Roboteurs/Pi-104/README.md

# Pi-104
Necessary files to build a PCIE/104 compliant carrier board for Raspberry Pi Compute module
