Roboteurs/Pi-104/hardware/bom.xlsx

 |  |  |  |  |  |  | Board Qty: | 100
 |  |  |  |  |  |  | Total Cost: | $0.00 |  |  |  | $0.00 |  |  |  |  |  | $0.00 |  |  |  |  |  | $0.00 |  |  |  |  |  | $0.00 |  |  |  |  |  | $0.00
 |  |  |  |  |  |  | Unit Cost: | $0.00
Global Part Info |  |  |  |  |  |  |  |  | Digi-Key |  |  |  |  |  | Farnell |  |  |  |  |  | Mouser |  |  |  |  |  | Newark |  |  |  |  |  | Rs Components
Refs | Value | Desc | Footprint | Manf | Manf# | Qty | Unit$ | Ext$ | Avail | Purch | Unit$ | Ext$ | Cat# | Doc | Avail | Purch | Unit$ | Ext$ | Cat# | Doc | Avail | Purch | Unit$ | Ext$ | Cat# | Doc | Avail | Purch | Unit$ | Ext$ | Cat# | Doc | Avail | Purch | Unit$ | Ext$ | Cat# | Doc
R8,R11,R12 | DNP |  | w_smd_resistors:r_0402 |  | - | 0 | $0.00 | $0.00
R9 | 30k |  | w_smd_resistors:r_0402 |  | ERJ-2RKF3002X | 0 | $0.00 | $0.00 | 144942 |  | $0.00 | $0.00 | P30.0KLCT-ND | Link (http://www.digikey.com/product-detail/en/panasonic-electronic-components/ERJ-2RKF3002X/P30.0KLCT-ND/1746668) | 60000 |  | $0.00 | $0.00 | 2397333 | Link (http://it.farnell.com/webapp/wcs/stores/servlet/Search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) | 78944 |  | $0.00 | $0.00 | 667-ERJ-2RKF3002X | Link (http://www.mouser.com/Search/Refine.aspx?Keyword=667-ERJ-2RKF3002X%20) | 3540 |  | $0.00 | $0.00 | 53W4321 | Link (http://www.newark.com/panasonic-electronic-components/erj-2rkf3002x/res-thick-film-30k-1-0-1w-0402/dp/53W4321) | 1 |  | $0.00 | $0.00 | 732-5438 | Link (http://it.rs-online.com/web/c/?searchTerm=ERJ-2RKF3002X%20)
J4 | RJ45_LEDS |  | project_foot:RJE72-188 |  | RJE721881411 | 0 | $0.00 | $0.00 | 73 |  | $0.00 | $0.00 | RJE72-188-1411-ND | Link (http://www.digikey.com/scripts/DkSearch/dksus.dll?WT.z_header=search_go&lang=en) | 118 |  | $0.00 | $0.00 | 2354249 | Link (http://it.farnell.com/amphenol-commercial-products/rje72-188-1411/jack-modulare-1-porta-8p8c-y-g/dp/2354249) | 404 |  | $0.00 | $0.00 | 523-RJE721881411 | Link (http://www.mouser.com/Search/Refine.aspx?Keyword=523-RJE721881411%20) | 529 |  | $0.00 | $0.00 | 47W2089 | Link (http://www.newark.com/webapp/wcs/stores/servlet/Search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)
R5 | 240 |  | w_smd_resistors:r_0603 |  | ESR03EZPJ241 | 0 | $0.00 | $0.00 | 43759 |  | $0.00 | $0.00 | RHM240DCT-ND | Link (http://www.digikey.com/product-detail/en/rohm-semiconductor/ESR03EZPJ241/RHM240DCT-ND/1762931) |  |  |  |  |  |  | 24616 |  | $0.00 | $0.00 | 755-ESR03EZPJ241 | Link (http://www.mouser.com/Search/Refine.aspx?Keyword=755-ESR03EZPJ241%20)
R4 | 24k |  | w_smd_resistors:r_0402 |  | ERJ-2GEJ243X | 0 | $0.00 | $0.00 | 21017 |  | $0.00 | $0.00 | P24KJCT-ND | Link (http://www.digikey.com/product-detail/en/panasonic-electronic-components/ERJ-2GEJ243X/P24KJCT-ND/146947) | 113735 |  | $0.00 | $0.00 | 2324288 | Link (http://it.farnell.com/panasonic-electronic-components/erj2gej243x/res-film-spesso-24k-5-0-1w-0402/dp/2324288) | 130424 |  | $0.00 | $0.00 | 667-ERJ-2GEJ243X | Link (http://www.mouser.com/Search/Refine.aspx?Keyword=667-ERJ-2GEJ243X%20) | 2534 |  | $0.00 | $0.00 | 53W4156 | Link (http://www.newark.com/panasonic-electronic-components/erj-2gej243x/res-thick-film-24k-5-0-1w-0402/dp/53W4156)
U2 | dmmt5401 |  | w_smd_trans:sot23-6 |  | DMMT5401-7-F | 0 | $0.00 | $0.00 | 26347 |  | $0.00 | $0.00 | DMMT5401-FDICT-ND | Link (http://www.digikey.com/product-detail/en/diodes-incorporated/DMMT5401-7-F/DMMT5401-FDICT-ND/717881) | 4157 |  | $0.00 | $0.00 | 1773583 | Link (http://it.farnell.com/diodes-inc/dmmt5401-7-f/transistor-accoppiato-pnp-pnp/dp/1773583) | 3089 |  | $0.00 | $0.00 | 621-DMMT5401-7-F | Link (http://www.mouser.com/Search/Refine.aspx?Keyword=621-DMMT5401-7-F%20) | 3629 |  | $0.00 | $0.00 | 51R6458 | Link (http://www.newark.com/webapp/wcs/stores/servlet/Search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) | 280 |  | $0.00 | $0.00 | 711-5049 | Link (http://it.rs-online.com/web/p/transistor-bipolari/7115049/)
F1 | 2A |  | w_smd_resistors:r_1206 |  | MF-NSMF200-2 | 0 | $0.00 | $0.00 | 12193 |  | $0.00 | $0.00 | MF-NSMF200-2CT-ND | Link (http://www.digikey.com/product-detail/en/bourns-inc/MF-NSMF200-2/MF-NSMF200-2CT-ND/1232791) |  |  |  |  |  |  | 8710 |  | $0.00 | $0.00 | 652-MF-NSMF200-2 | Link (http://www.mouser.com/Search/Refine.aspx?Keyword=652-MF-NSMF200-2%20) | 2957 |  | $0.00 | $0.00 | 75K7626 | Link (http://www.newark.com/bourns/nsmf200-2/fuse-ptc-reset-6v-2a-1206/dp/75K7626) |  |  |  |  |  | Link (http://it.rs-online.com/web/c/?searchTerm=MF-NSMF200-2%20)
R27-R30 | 49.9R |  | w_smd_resistors:r_0402 |  | RG1005P-49R9-B-T5 | 0 | $0.00 | $0.00 | 77420 |  | $0.00 | $0.00 | RG10P49.9BCT-ND | Link (http://www.digikey.com/product-detail/en/susumu/RG1005P-49R9-B-T5/RG10P49.9BCT-ND/969051) | 2476 |  | $0.00 | $0.00 | 2330716 | Link (http://it.farnell.com/te-connectivity/cpf0402b49r9e1/res-film-sott-49r9-0-1-0-063w/dp/2330716?iscrfnonsku=true) | 6849 |  | $0.00 | $0.00 | 754-RG1005P-49R9-BT5 | Link (http://www.mouser.com/Search/Refine.aspx?Keyword=754-RG1005P-49R9-BT5%20)
P11 | CAM0 FCI Connector |  | project_foot:1-84952-5 |  | 1-84952-5 | 0 | $0.00 | $0.00 | 9056 |  | $0.00 | $0.00 | A101391CT-ND | Link (http://www.digikey.com/product-detail/en/te-connectivity-amp-connectors/1-84952-5/A101391CT-ND/2567527) |  |  |  |  |  | Link (http://it.farnell.com/te-connectivity-amp/1-84952-5/fpc-connector-receptacle-15pos/dp/1846445) | 283 |  | $0.00 | $0.00 | 571-1-84952-5 | Link (http://www.mouser.com/Search/Refine.aspx?Keyword=571-1-84952-5%20%20) |  |  |  |  |  | Link (http://www.newark.com/webapp/wcs/stores/servlet/Search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)
SW3 | Switch_SPDT_x2 |  | project_foot:SSSS820201 |  | SSSS820201 | 0 | $0.00 | $0.00 |  |  |  |  |  |  |  |  |  |  |  |  | 385 |  | $0.00 | $0.00 | 688-SSSS820201 | Link (http://www.mouser.com/Search/Refine.aspx?Keyword=688-SSSS820201%20) |  |  |  |  |  |  |  |  |  |  |  | Link (http://it.rs-online.com/web/c/?searchTerm=SSSS820201%20)
U3 | PAM2306A |  | w_smd_qfn:dfn12 |  | PAM2306AYPKE | 0 | $0.00 | $0.00 |  |  |  |  |  | Link (http://www.digikey.com/scripts/DkSearch/dksus.dll?WT.z_header=search_go&lang=en) |  |  |  |  |  |  | 6730 |  | $0.00 | $0.00 | 621-PAM2306AYPKE | Link (http://www.mouser.com/Search/Refine.aspx?Keyword=621-PAM2306AYPKE%20) |  |  |  |  |  |  | 2140 |  | $0.00 | $0.00 | 921-0751 | Link (http://it.rs-online.com/web/c/?searchTerm=PAM2306AYPKE%20)
R1 | 10k |  | w_smd_resistors:r_0402 |  | ERJ-2GEJ103X | 0 | $0.00 | $0.00 | 4213026 |  | $0.00 | $0.00 | P10KJCT-ND | Link (http://www.digikey.com/product-detail/en/panasonic-electronic-components/ERJ-2GEJ103X/P10KJCT-ND/146734) | 55245 |  | $0.00 | $0.00 | 2059239 | Link (http://it.farnell.com/panasonic-electronic-components/erj2gej103x/res-film-spesso-10k-5-0-1w-0402/dp/2059239) | 1561201 |  | $0.00 | $0.00 | 667-ERJ-2GEJ103X | Link (http://www.mouser.com/Search/Refine.aspx?Keyword=667-ERJ-2GEJ103X%20) | 3111 |  | $0.00 | $0.00 | 65T8248 | Link (http://www.newark.com/panasonic-electronic-components/erj-2gej103x/res-thick-film-10k-5-0-1w-0402/dp/65T8248) |  |  |  |  |  | Link (http://it.rs-online.com/web/p/resistori-smd/7324861/)
C25,C26,C51,C52 | 100n/50V |  | w_smd_cap:c_0402 |  | GRM155R71H104KE14J | 0 | $0.00 | $0.00 | 4873 |  | $0.00 | $0.00 | 490-13342-1-ND | Link (http://www.digikey.com/product-detail/en/murata-electronics-north-america/GRM155R71H104KE14J/490-13342-1-ND/5973352) |  |  |  |  |  | Link (http://it.farnell.com/tdk/cga2b3x7r1h104k050bb/condensatore-mlcc-x7r-100nf-50v/dp/2210822?iscrfnonsku=true) | 270973 |  | $0.00 | $0.00 | 81-GRM155R71H104KE4J | Link (http://www.mouser.com/Search/../ProductDetail/Murata-Electronics/GRM155R71H104KE14J/) | 2390 |  | $0.00 | $0.00 | 04X3230 | Link (http://www.newark.com/tdk/c1005x7r1h104k050bb/ceramic-capacitor-0-1uf-50v-x7r/dp/04X3230?iscrfnonsku=true) |  |  |  |  |  | Link (http://it.rs-online.com/web/p/condensatori-ceramici-multistrato/8847087/)
D4 | LED |  | w_smd_leds:Led_0603 |  | HT-191YG-5310 | 0 | $0.00 | $0.00 |  |  |  |  |  |  |  |  |  |  |  |  | 579 |  | $0.00 | $0.00 | 743-HT-191YG | Link (http://www.mouser.com/Search/Refine.aspx?Keyword=743-HT-191YG%20)
X1 | 25.000MHz |  | w_crystal:crystal_smd_5x3.2mm |  | ABM3-25.000MHZ-B2-T | 0 | $0.00 | $0.00 | 13229 |  | $0.00 | $0.00 | 535-9108-1-ND | Link (http://www.digikey.com/product-detail/en/abracon-llc/ABM3-25.000MHZ-B2-T/535-9108-1-ND/675625) | 3868 |  | $0.00 | $0.00 | 1703612 | Link (http://it.farnell.com/abracon/abm3-25-000mhz-b2-t/crystal/dp/1703612) | 5304 |  | $0.00 | $0.00 | 815-ABM3-25-B2-T | Link (http://www.mouser.com/Search/Refine.aspx?Keyword=815-ABM3-25-B2-T%20) | 343 |  | $0.00 | $0.00 | 13J1725 | Link (http://www.newark.com/abracon/abm3-25-000mhz-b2-t/crystal-25mhz-18pf-5-x-3-2mm/dp/13J1725)
C15-C19 | 10nf/50V |  | w_smd_cap:c_0402 |  | 04025C103KAT2A | 0 | $0.00 | $0.00 | 168732 |  | $0.00 | $0.00 | 478-7882-1-ND | Link (http://www.digikey.com/product-detail/en/avx-corporation/04025C103KAT2A/478-7882-1-ND/3881505) | 2779 |  | $0.00 | $0.00 | 2332514 | Link (http://it.farnell.com/avx/04025c103kat2a/condensatore-mlcc-x7r-10nf-50v/dp/2332514) | 58594 |  | $0.00 | $0.00 | 581-04025C103KAT2A | Link (http://www.mouser.com/Search/../ProductDetail/AVX/04025C103KAT2A/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) | 3897 |  | $0.00 | $0.00 | 94W2844 | Link (http://www.newark.com/avx/04025c103kat2a/capacitor-ceramic-0-01uf-50v-x7r/dp/94W2844)
C3,C27,C30 | 4.7uf6.3V |  | w_smd_cap:c_0402 |  | 04026D475KAT2A | 0 | $0.00 | $0.00 |  |  |  |  |  |  |  |  |  |  |  |  | 4730 |  | $0.00 | $0.00 | 581-04026D475KAT2A | Link (http://www.mouser.com/Search/Refine.aspx?Keyword=581-04026D475KAT2A%20) |  |  |  |  |  | Link (http://www.newark.com/webapp/wcs/stores/servlet/Search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)
U7 | TS3USB3031 |  | project_foot:PWQFN-N12 |  | TS3USB3031RMGR | 0 | $0.00 | $0.00 | 1539 |  | $0.00 | $0.00 | 296-41018-1-ND | Link (http://www.digikey.com/product-detail/en/texas-instruments/TS3USB3031RMGR/296-41018-1-ND/5178895) |  |  |  |  |  |  | 5899 |  | $0.00 | $0.00 | 595-TS3USB3031RMGR | Link (http://www.mouser.com/Search/Refine.aspx?Keyword=595-TS3USB3031RMGR%20)
F2,F3 | 1A |  | w_smd_resistors:r_1206 |  | MF-NSMF075-2 | 0 | $0.00 | $0.00 | 5313 |  | $0.00 | $0.00 | MF-NSMF075-2CT-ND | Link (http://www.digikey.com/product-detail/en/bourns-inc/MF-NSMF075-2/MF-NSMF075-2CT-ND/662835) | 2296 |  | $0.00 | $0.00 | 1206719 | Link (http://it.farnell.com/bourns/nsmf075-2/multifuse-smd-0-75a/dp/1206719) |  |  |  |  |  |  |  |  |  |  |  |  | 560 |  | $0.00 | $0.00 | 647-8285 | Link (http://it.rs-online.com/web/c/?searchTerm=MF-NSMF075-2%20)
R31 | 10R |  | w_smd_resistors:r_0402 |  | RK73H1ERTTP10R0F | 0 | $0.00 | $0.00 |  |  |  |  |  |  | 20000 |  | $0.00 | $0.00 | 2355505 | Link (http://it.farnell.com/webapp/wcs/stores/servlet/Search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) |  |  |  |  |  |  | 15101 |  | $0.00 | $0.00 | 51W2911 | Link (http://www.newark.com/panasonic-electronic-components/erj-u02f10r0x/res-thick-film-10r-1-0-1w-0402/dp/51W2911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)
R53,R54,R56 | 47k |  | w_smd_resistors:r_0402 |  | CRCW040247K0FKED | 0 | $0.00 | $0.00 | 330389 |  | $0.00 | $0.00 | 541-47.0KLCT-ND | Link (http://www.digikey.com/product-detail/en/vishay-dale/CRCW040247K0FKED/541-47.0KLCT-ND/1183313) | 24658 |  | $0.00 | $0.00 | 1469719 | Link (http://it.farnell.com/vishay/crcw040247k0fked/res-film-spesso-47k-1-0-063w-0402/dp/1469719) |  |  |  |  |  |  | 8595 |  | $0.00 | $0.00 | 52K7097 | Link (http://www.newark.com/vishay/crcw040247k0fked/res-thick-film-47k-1-0-063w-0402/dp/52K7097) | 200 |  | $0.00 | $0.00 | 678-9361 | Link (http://it.rs-online.com/web/p/resistori-smd/6789361/)
C11,C12 | DNP |  | w_smd_cap:c_0402 |  | - | 0 | $0.00 | $0.00
L4-L6 | 2A FTBEAD |  | w_smd_inductors:inductor_smd_0603 |  | BLM18PG121SN1D | 0 | $0.00 | $0.00 | 815714 |  | $0.00 | $0.00 | 490-1037-1-ND | Link (http://www.digikey.com/product-detail/en/murata-electronics-north-america/BLM18PG121SN1D/490-1037-1-ND/584485) | 20477 |  | $0.00 | $0.00 | 1515738 | Link (http://it.farnell.com/murata/blm18pg121sn1d/ferrite-perlina-0603-0-05ohm-2a/dp/1515738) |  |  |  |  |  |  | 28852 |  | $0.00 | $0.00 | 73M9109 | Link (http://www.newark.com/webapp/wcs/stores/servlet/Search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) | 1100 |  | $0.00 | $0.00 | 724-1380 | Link (http://it.rs-online.com/web/c/?searchTerm=BLM18PG121SN1D%20)
R10 | 10k |  | w_smd_resistors:r_0402 |  | ERJ-2GEJ103X | 0 | $0.00 | $0.00 | 4213026 |  | $0.00 | $0.00 | P10KJCT-ND | Link (http://www.digikey.com/product-detail/en/panasonic-electronic-components/ERJ-2GEJ103X/P10KJCT-ND/146734) | 55245 |  | $0.00 | $0.00 | 2059239 | Link (http://it.farnell.com/panasonic-electronic-components/erj2gej103x/res-film-spesso-10k-5-0-1w-0402/dp/2059239) |  |  |  |  |  |  | 3111 |  | $0.00 | $0.00 | 65T8248 | Link (http://www.newark.com/panasonic-electronic-components/erj-2gej103x/res-thick-film-10k-5-0-1w-0402/dp/65T8248) |  |  |  |  |  | Link (http://it.rs-online.com/web/p/resistori-smd/7324861/)
U1 | AP7115 |  | w_smd_trans:sot323-5 |  | AP7115-25SEG-7 | 0 | $0.00 | $0.00 | 6966 |  | $0.00 | $0.00 | AP7115-25SEGDICT-ND | Link (http://www.digikey.com/product-detail/en/diodes-incorporated/AP7115-25SEG-7/AP7115-25SEGDICT-ND/2044560) |  |  |  |  |  |  |  |  |  |  |  |  |  |  |  |  |  |  | 2050 |  | $0.00 | $0.00 | 828-7656 | Link (http://it.rs-online.com/web/p/regolatori-di-tensione-low-dropout/8287656/)
D1 | 0.6V |  | w_smd_diode:do214aa |  | MBRS140 | 0 | $0.00 | $0.00 | 11948 |  | $0.00 | $0.00 | MBRS140FSCT-ND | Link (http://www.digikey.com/product-detail/en/fairchild-on-semiconductor/MBRS140/MBRS140FSCT-ND/2094422) |  |  |  |  |  |  |  |  |  |  |  |  | 721 |  | $0.00 | $0.00 | 58K1806 | Link (http://www.newark.com/fairchild-semiconductor/mbrs140/schottky-rectifier-1a-40v-do-214aa/dp/58K1806) | 362 |  | $0.00 | $0.00 | 545-2074 | Link (http://it.rs-online.com/web/p/diodi-rettificatori-e-schottky/5452074/)
R40 | 27k |  | w_smd_resistors:r_0402 |  | ERJ-2GEJ273X | 0 | $0.00 | $0.00 | 523925 |  | $0.00 | $0.00 | P27KJCT-ND | Link (http://www.digikey.com/product-detail/en/panasonic-electronic-components/ERJ-2GEJ273X/P27KJCT-ND/146955) | 1567 |  | $0.00 | $0.00 | 2059244 | Link (http://it.farnell.com/panasonic-electronic-components/erj2gej273x/res-film-spesso-27k-5-0-1w-0402/dp/2059244) |  |  |  |  |  |  | 6290 |  | $0.00 | $0.00 | 65T8276 | Link (http://www.newark.com/panasonic-electronic-components/erj-2gej273x/res-thick-film-27k-5-0-1w-0402/dp/65T8276) |  |  |  |  |  | Link (http://it.rs-online.com/web/c/?searchTerm=ERJ-2GEJ273X%20)
U10 | ESD5384 |  | project_foot:WLCSP9 |  | ESD5384NCTBG | 0 | $0.00 | $0.00 |  |  |  |  |  | Link (http://www.digikey.com/product-detail/en/on-semiconductor/ESD5384NCTBG/ESD5384NCTBGOSCT-ND/5801808) |  |  |  |  |  |  |  |  |  |  |  |  |  |  |  |  |  |  | 4500 |  | $0.00 | $0.00 | 801-0213 | Link (http://it.rs-online.com/web/c/?searchTerm=ESD5384NCTBG%20)
J2 | OneBank |  | project_foot:ASP-129646-22 |  | ASP-129646-22 | 0 | $0.00 | $0.00
Q2,Q3 | DMG1012T |  | project_foot:SOT523 |  | DMG1012T-7 | 0 | $0.00 | $0.00 | 231192 |  | $0.00 | $0.00 | DMG1012T-7DICT-ND | Link (http://www.digikey.com/product-detail/en/diodes-incorporated/DMG1012T-7/DMG1012T-7DICT-ND/2181232) | 927 |  | $0.00 | $0.00 | 2543524 | Link (http://it.farnell.com/diodes-inc/dmg1012t-7/mosfet-ca-n-20v-sot-523/dp/2543524) |  |  |  |  |  |  | 767 |  | $0.00 | $0.00 | 82Y6555 | Link (http://www.newark.com/webapp/wcs/stores/servlet/Search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) | 4700 |  | $0.00 | $0.00 | 751-4064 | Link (http://it.rs-online.com/web/p/transistor-mosfet/7514064/)
U5 | FDC5614P |  | w_smd_trans:sot23-6 |  | FDC5614P | 0 | $0.00 | $0.00 | 618 |  | $0.00 | $0.00 | FDC5614PCT-ND | Link (http://www.digikey.com/product-detail/en/fairchild-on-semiconductor/FDC5614P/FDC5614PCT-ND/965578) | 9489 |  | $0.00 | $0.00 | 1471036 | Link (http://it.farnell.com/fairchild-semiconductor/fdc5614p/mosfet-p-smd-ssot-6/dp/1471036) |  |  |  |  |  |  | 645 |  | $0.00 | $0.00 | 34C0107 | Link (http://www.newark.com/fairchild-semiconductor/fdc5614p/p-channel-mosfet-60v-3a-super/dp/34C0107) | 30 |  | $0.00 | $0.00 | 671-0346 | Link (http://it.rs-online.com/web/p/transistor-mosfet/6710346/)
J3 | MICRO_USB |  | w_conn_pc:conn_usb_B_micro_smd-2 |  | 47346-0001 | 0 | $0.00 | $0.00 |  |  |  |  |  |  | 7922 |  | $0.00 | $0.00 | 1568026 | Link (http://it.farnell.com/molex/47346-0001/micro-usb-2-0-tipo-b-presa-smt/dp/1568026) |  |  |  |  |  |  | 962 |  | $0.00 | $0.00 | 47M0505 | Link (http://www.newark.com/molex/47346-0001/micro-usb-2-0-type-b-receptacle/dp/47M0505) | 35 |  | $0.00 | $0.00 | 702-5475 | Link (http://it.rs-online.com/web/c/?searchTerm=47346-0001%20)
R20 | 12k |  | w_smd_resistors:r_0402 |  | CPF0402B12KE1 | 0 | $0.00 | $0.00 | 5181 |  | $0.00 | $0.00 | A102603CT-ND | Link (http://www.digikey.com/product-detail/en/te-connectivity-passive-product/CPF0402B12KE1/A102603CT-ND/2729136) | 2317 |  | $0.00 | $0.00 | 1697335 | Link (http://it.farnell.com/te-connectivity-neohm/cpf0402b12ke1/res-film-sott-12k-0-1-0-063w-0402/dp/1697335) |  |  |  |  |  |  | 1502 |  | $0.00 | $0.00 | 80P3858 | Link (http://www.newark.com/webapp/wcs/stores/servlet/Search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) |  |  |  |  |  | Link (http://it.rs-online.com/web/c/?searchTerm=CPF0402B12KE1%20)
U6 | DDR2_SODIMM |  | Sockets:Socket_SODIMM_DDR1-2_TE_1612618_Debug |  | 1612618-4 | 0 | $0.00 | $0.00 | 400 |  | $0.00 | $0.00 | A114913-ND | Link (http://www.digikey.com/scripts/DkSearch/dksus.dll?WT.z_header=search_go&lang=en) | 785 |  | $0.00 | $0.00 | 2396418 | Link (http://it.farnell.com/webapp/wcs/stores/servlet/Search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) |  |  |  |  |  |  | 4753 |  | $0.00 | $0.00 | 58K3620 | Link (http://www.newark.com/webapp/wcs/stores/servlet/Search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) | 18 |  | $0.00 | $0.00 | 718-4723 | Link (http://it.rs-online.com/web/c/?searchTerm=1612618-4%20)
L3 | 22uH/2.2A/100mO |  | w_smd_inductors:inductor_smd_8x5mm |  | SRN8040-220M | 0 | $0.00 | $0.00 | 16066 |  | $0.00 | $0.00 | SRN8040-220MCT-ND | Link (http://www.digikey.com/product-detail/en/bourns-inc/SRN8040-220M/SRN8040-220MCT-ND/2756182) | 1240 |  | $0.00 | $0.00 | 2061671 | Link (http://it.farnell.com/bourns/srn8040-220m/inductor-power-22uh-semi-shielded/dp/2061671) |  |  |  |  |  |  | 699 |  | $0.00 | $0.00 | 64T2399 | Link (http://www.newark.com/bourns/srn8040-220m/inductor-shielded-22uh-2-2a-smd/dp/64T2399) | 30 |  | $0.00 | $0.00 | 743-5188 | Link (http://it.rs-online.com/web/c/?searchTerm=SRN8040-220M%20)
SW1 | Rotary or Slide Select Switch |  | project_foot:SSSS820201 |  | SSSS820201 | 0 | $0.00 | $0.00 |  |  |  |  |  |  |  |  |  |  |  |  |  |  |  |  |  |  |  |  |  |  |  |  |  |  |  |  |  | Link (http://it.rs-online.com/web/c/?searchTerm=SSSS820201%20)
R14 | DNP |  | w_smd_resistors:r_0603 |  | - | 0 | $0.00 | $0.00
R6,R7,R13,R36-R39,R46-R48 | 0R |  | w_smd_resistors:r_0402 |  | CRCW04020000Z0ED | 0 | $0.00 | $0.00 | 1521711 |  | $0.00 | $0.00 | 541-0.0JCT-ND | Link (http://www.digikey.com/product-detail/en/vishay-dale/CRCW04020000Z0ED/541-0.0JCT-ND/1182611) | 69337 |  | $0.00 | $0.00 | 1469661 | Link (http://it.farnell.com/vishay/crcw04020000z0ed/resistore0r-0-063w-ponticello/dp/1469661) |  |  |  |  |  |  | 6692 |  | $0.00 | $0.00 | 52K6543 | Link (http://www.newark.com/vishay/crcw04020000z0ed/res-thick-film-0r-0-063w-0402/dp/52K6543) | 5000 |  | $0.00 | $0.00 | 393-2326 | Link (http://it.rs-online.com/web/p/resistori-smd/3932326/)
C8 | 1nf/50V |  | w_smd_resistors:r_0402 |  | GRM1555C1H102JA01D | 0 | $0.00 | $0.00 | 4073265 |  | $0.00 | $0.00 | 490-3244-1-ND | Link (http://www.digikey.com/product-detail/en/murata-electronics-north-america/GRM1555C1H102JA01D/490-3244-1-ND/702785) | 75951 |  | $0.00 | $0.00 | 8819556 | Link (http://it.farnell.com/murata/grm1555c1h102ja01d/condens-mlcc-c0g-np0-1nf-50v-0402/dp/8819556) |  |  |  |  |  |  | 4681 |  | $0.00 | $0.00 | 38K1651 | Link (http://www.newark.com/murata/grm1555c1h102ja01d/ceramic-capacitor-1000pf-50v-c0g/dp/38K1651) | 100 |  | $0.00 | $0.00 | 624-2913 | Link (http://it.rs-online.com/web/c/?searchTerm=GRM1555C1H102JA01D%20)
SW2 | DIPS_03 |  | project_foot:ADF03S04 |  | ADF03S04 | 0 | $0.00 | $0.00 |  |  |  |  |  |  |  |  |  |  |  |  |  |  |  |  |  |  |  |  |  |  |  |  | 48 |  | $0.00 | $0.00 | 639-3061 | Link (http://it.rs-online.com/web/p/interruttori-dip-e-sip/6393061/)
J5 | HDMI_CONN |  | project_foot:10029449-111RLF |  | 10029449-111RLF | 0 | $0.00 | $0.00 | 16146 |  | $0.00 | $0.00 | 609-4614-1-ND | Link (http://www.digikey.com/product-detail/en/amphenol-fci/10029449-111RLF/609-4614-1-ND/2785376) |  |  |  |  |  | Link (http://it.farnell.com/webapp/wcs/stores/servlet/Search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) |  |  |  |  |  |  |  |  |  |  |  | Link (http://www.newark.com/webapp/wcs/stores/servlet/Search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)
C20-C22,C24 | 47uf/10V |  | w_smd_cap:c_1210 |  | C1210C476M8PACTU | 0 | $0.00 | $0.00 | 36297 |  | $0.00 | $0.00 | 399-5515-1-ND | Link (http://www.digikey.com/product-detail/en/kemet/C1210C476M8PACTU/399-5515-1-ND/1950693) | 1234 |  | $0.00 | $0.00 | 2112938 | Link (http://it.farnell.com/kemet/c1210c476m8pactu/condensatore-mlcc-x5r-47uf-10v/dp/2112938) |  |  |  |  |  |  | 1874 |  | $0.00 | $0.00 | 12N4446 | Link (http://www.newark.com/kemet/c1210c476m8pactu/ceramic-capacitor-47uf-10v-x5r/dp/12N4446) | 235 |  | $0.00 | $0.00 | 803-0065 | Link (http://it.rs-online.com/web/p/condensatori-ceramici-multistrato/8030065/)
R65 | 1M |  | w_smd_resistors:r_0402 |  | CRCW04021M00FKED | 0 | $0.00 | $0.00 | 223527 |  | $0.00 | $0.00 | 541-1.00MLCT-ND | Link (http://www.digikey.com/product-detail/en/vishay-dale/CRCW04021M00FKED/541-1.00MLCT-ND/1183465) | 66016 |  | $0.00 | $0.00 | 1469667 | Link (http://it.farnell.com/vishay/crcw04021m00fked/res-film-spesso-1m-1-0-063w-0402/dp/1469667) |  |  |  |  |  |  | 7212 |  | $0.00 | $0.00 | 52K6593 | Link (http://www.newark.com/vishay/crcw04021m00fked/res-thick-film-1m-1-0-063w-0402/dp/52K6593) | 7750 |  | $0.00 | $0.00 | 678-8923 | Link (http://it.rs-online.com/web/p/resistori-smd/6788923/)
C5 | 4.7uf/50V |  | w_smd_cap:c_elec_4x5.7 |  | EMVA500ADA4R7MD55G | 0 | $0.00 | $0.00 | 2991 |  | $0.00 | $0.00 | 565-2128-1-ND | Link (http://www.digikey.com/product-detail/en/united-chemi-con/EMVA500ADA4R7MD55G/565-2128-1-ND/757289) | 4 |  | $0.00 | $0.00 | 1698399 | Link (http://it.farnell.com/webapp/wcs/stores/servlet/Search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) |  |  |  |  |  |  | 4 |  | $0.00 | $0.00 | 09P9249 | Link (http://www.newark.com/united-chemi-con/emva500ada4r7md55g/aluminum-electrolytic-capacitor/dp/09P9249) | 175 |  | $0.00 | $0.00 | 756-8017 | Link (http://it.rs-online.com/web/c/?searchTerm=EMVA500ADA4R7MD55G%20)
R51,R52,R55 | 1k |  | w_smd_resistors:r_0402 |  | CRCW04021K00FKED | 0 | $0.00 | $0.00 | 415249 |  | $0.00 | $0.00 | 541-1.00KLCT-ND | Link (http://www.digikey.com/product-detail/en/vishay-dale/CRCW04021K00FKED/541-1.00KLCT-ND/1183123) | 40809 |  | $0.00 | $0.00 | 1469662 | Link (http://it.farnell.com/vishay/crcw04021k00fked/res-film-spesso-1k-1-0-063w-0402/dp/1469662) |  |  |  |  |  |  | 6517 |  | $0.00 | $0.00 | 52K6545 | Link (http://www.newark.com/vishay/crcw04021k00fked/res-thick-film-1k-1-0-063w-0402/dp/52K6545) | 100 |  | $0.00 | $0.00 | 678-8872 | Link (http://it.rs-online.com/web/p/resistori-smd/6788872/)
P9,P13 | USB_A |  | project_foot:4825-80002 |  | 48258-0002 | 0 | $0.00 | $0.00 | 16608 |  | $0.00 | $0.00 | WM7087CT-ND | Link (http://www.digikey.com/product-detail/en/molex-llc/0482580002/WM7087CT-ND/3045006) |  |  |  |  |  |  |  |  |  |  |  |  | 11187 |  | $0.00 | $0.00 | 48T6726 | Link (http://www.newark.com/webapp/wcs/stores/servlet/Search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)
P10 | DISP0 FCI Connector |  | project_foot:1-84952-5 |  | 1-84952-5 | 0 | $0.00 | $0.00 | 9056 |  | $0.00 | $0.00 | A101391CT-ND | Link (http://www.digikey.com/product-detail/en/te-connectivity-amp-connectors/1-84952-5/A101391CT-ND/2567527) |  |  |  |  |  | Link (http://it.farnell.com/te-connectivity-amp/1-84952-5/fpc-connector-receptacle-15pos/dp/1846445) |  |  |  |  |  |  |  |  |  |  |  | Link (http://www.newark.com/webapp/wcs/stores/servlet/Search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)
R3,R41-R45 | 100k |  | w_smd_resistors:r_0402 |  | ERJ-2GEJ104X | 0 | $0.00 | $0.00 | 2402792 |  | $0.00 | $0.00 | P100KJCT-ND | Link (http://www.digikey.com/product-detail/en/panasonic-electronic-components/ERJ-2GEJ104X/P100KJCT-ND/146730) | 20693 |  | $0.00 | $0.00 | 2059250 | Link (http://it.farnell.com/panasonic-electronic-components/erj2gej104x/res-film-spesso-100k-5-0-1w-0402/dp/2059250) |  |  |  |  |  |  | 1106 |  | $0.00 | $0.00 | 65T8249 | Link (http://www.newark.com/panasonic-electronic-components/erj-2gej104x/res-thick-film-100k-5-0-1w-0402/dp/65T8249) |  |  |  |  |  | Link (http://it.rs-online.com/web/c/?searchTerm=ERJ-2GEJ104X%20)
R17,R32,R33,R35,R49 | 390R |  | w_smd_resistors:r_0402 |  | ERJ-2RKF3900X | 0 | $0.00 | $0.00 | 118516 |  | $0.00 | $0.00 | P390LCT-ND | Link (http://www.digikey.com/product-detail/en/panasonic-electronic-components/ERJ-2RKF3900X/P390LCT-ND/1746681) | 9951 |  | $0.00 | $0.00 | 2302590 | Link (http://it.farnell.com/panasonic-electronic-components/erj2rkf3900x/res-film-spesso-390r-1-0-1w-0402/dp/2302590) |  |  |  |  |  |  | 11745 |  | $0.00 | $0.00 | 64R5282 | Link (http://www.newark.com/panasonic-electronic-components/erj-2rkf3900x/res-thick-film-390r-1-0-1w-0402/dp/64R5282) |  |  |  |  |  | Link (http://it.rs-online.com/web/c/?searchTerm=ERJ-2RKF3900X%20)
T1 | H1102 |  | project_foot:H1102 |  | H1102NL | 0 | $0.00 | $0.00 | 7235 |  | $0.00 | $0.00 | 553-1323-5-ND | Link (http://www.digikey.com/product-detail/en/pulse-electronics-corporation/H1102NL/553-1323-5-ND/1036940)
P12 | CONN_02X20 |  | w_conn_strip:vasch_strip_20x2 |  | N2540-6002RB | 0 | $0.00 | $0.00 | 1738 |  | $0.00 | $0.00 | MHC40K-ND | Link (http://www.digikey.com/scripts/DkSearch/dksus.dll?WT.z_header=search_go&lang=en) | 584 |  | $0.00 | $0.00 | 9838309 | Link (http://it.farnell.com/3m/n2540-6002rb/header-diritta-40-vie/dp/9838309) |  |  |  |  |  |  | 96 |  | $0.00 | $0.00 | 18M6812 | Link (http://www.newark.com/webapp/wcs/stores/servlet/Search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) |  |  |  |  |  | Link (http://it.rs-online.com/web/c/?searchTerm=N2540-6002RB%20)
C32,C35 | 27pf |  | w_smd_cap:c_0402 |  | 04025A270FAT2A | 0 | $0.00 | $0.00 |  |  |  |  |  | Link (http://www.digikey.com/scripts/DkSearch/dksus.dll?WT.z_header=search_go&lang=en) | 5916 |  | $0.00 | $0.00 | 2332503 | Link (http://it.farnell.com/avx/04025a270fat2a/condens-mlcc-c0g-np0-27pf-50v/dp/2332503) |  |  |  |  |  |  | 15076 |  | $0.00 | $0.00 | 94W2841 | Link (http://www.newark.com/avx/04025a270fat2a/capacitor-ceramic-27pf-50v-c0g/dp/94W2841) |  |  |  |  |  | Link (http://it.rs-online.com/web/c/?searchTerm=04025A270FAT2A%20)
C4 | 100nf/50V |  | w_smd_cap:c_0402 |  | GRM155R71H104KE14J | 0 | $0.00 | $0.00 | 4873 |  | $0.00 | $0.00 | 490-13342-1-ND | Link (http://www.digikey.com/product-detail/en/murata-electronics-north-america/GRM155R71H104KE14J/490-13342-1-ND/5973352) |  |  |  |  |  | Link (http://it.farnell.com/tdk/cga2b3x7r1h104k050bb/condensatore-mlcc-x7r-100nf-50v/dp/2210822?iscrfnonsku=true) |  |  |  |  |  |  | 2390 |  | $0.00 | $0.00 | 04X3230 | Link (http://www.newark.com/tdk/c1005x7r1h104k050bb/ceramic-capacitor-0-1uf-50v-x7r/dp/04X3230?iscrfnonsku=true) |  |  |  |  |  | Link (http://it.rs-online.com/web/p/condensatori-ceramici-multistrato/8847087/)
C1 | 1uf/6V |  | w_smd_resistors:r_0402 |  | GRM155R70J105KA12J | 0 | $0.00 | $0.00 | 7495 |  | $0.00 | $0.00 | 490-10024-1-ND | Link (http://www.digikey.com/product-detail/en/murata-electronics-north-america/GRM155R70J105KA12D/490-10024-1-ND/5026378) |  |  |  |  |  |  |  |  |  |  |  |  |  |  |  |  |  |  | 2500 |  | $0.00 | $0.00 | 113-8711 | Link (http://it.rs-online.com/web/p/condensatori-ceramici-multistrato/1138711/)
C23,C28,C29,C31,C33,C34,C36-C44 | 0.1uf/50V |  | w_smd_cap:c_0402 |  | GRM155R71H104KE14J | 0 | $0.00 | $0.00 | 4873 |  | $0.00 | $0.00 | 490-13342-1-ND | Link (http://www.digikey.com/product-detail/en/murata-electronics-north-america/GRM155R71H104KE14J/490-13342-1-ND/5973352) |  |  |  |  |  | Link (http://it.farnell.com/tdk/cga2b3x7r1h104k050bb/condensatore-mlcc-x7r-100nf-50v/dp/2210822?iscrfnonsku=true) |  |  |  |  |  |  | 2390 |  | $0.00 | $0.00 | 04X3230 | Link (http://www.newark.com/tdk/c1005x7r1h104k050bb/ceramic-capacitor-0-1uf-50v-x7r/dp/04X3230?iscrfnonsku=true) |  |  |  |  |  | Link (http://it.rs-online.com/web/p/condensatori-ceramici-multistrato/8847087/)
U12-U17 | Hole |  |  |  |  | 0 | $0.00 | $0.00
R15,R16 | 47R |  | w_smd_resistors:r_0402 |  | RG1005P-470-D-T10 | 0 | $0.00 | $0.00 | 38820 |  | $0.00 | $0.00 | 408-1675-1-ND | Link (http://www.digikey.com/product-detail/en/susumu/RG1005P-470-D-T10/408-1675-1-ND/1288068) | 8827 |  | $0.00 | $0.00 | 2324743 | Link (http://it.farnell.com/webapp/wcs/stores/servlet/Search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)
R2 | 47k |  | w_smd_resistors:r_0402 |  | CRCW040247K0FKED | 0 | $0.00 | $0.00 | 330389 |  | $0.00 | $0.00 | 541-47.0KLCT-ND | Link (http://www.digikey.com/product-detail/en/vishay-dale/CRCW040247K0FKED/541-47.0KLCT-ND/1183313) | 24658 |  | $0.00 | $0.00 | 1469719 | Link (http://it.farnell.com/vishay/crcw040247k0fked/res-film-spesso-47k-1-0-063w-0402/dp/1469719) |  |  |  |  |  |  | 8595 |  | $0.00 | $0.00 | 52K7097 | Link (http://www.newark.com/vishay/crcw040247k0fked/res-thick-film-47k-1-0-063w-0402/dp/52K7097) | 200 |  | $0.00 | $0.00 | 678-9361 | Link (http://it.rs-online.com/web/p/resistori-smd/6789361/)
R61-R64 | 1.8k |  | w_smd_resistors:r_0402 |  | ERJ-2GEJ182X | 0 | $0.00 | $0.00 | 160836 |  | $0.00 | $0.00 | P1.8KJCT-ND | Link (http://www.digikey.com/product-detail/en/panasonic-electronic-components/ERJ-2GEJ182X/P1.8KJCT-ND/146921) | 18066 |  | $0.00 | $0.00 | 2324274 | Link (http://it.farnell.com/panasonic-electronic-components/erj2gej182x/res-film-spesso-1k8-5-0-1w-0402/dp/2324274) |  |  |  |  |  |  | 610 |  | $0.00 | $0.00 | 53W4149 | Link (http://www.newark.com/panasonic-electronic-components/erj-2gej182x/res-thick-film-1k8-5-0-1w-0402/dp/53W4149)
C2 | 100nf/50V |  | w_smd_resistors:r_0402 |  | GRM155R71H104KE14J | 0 | $0.00 | $0.00 | 4873 |  | $0.00 | $0.00 | 490-13342-1-ND | Link (http://www.digikey.com/product-detail/en/murata-electronics-north-america/GRM155R71H104KE14J/490-13342-1-ND/5973352) |  |  |  |  |  | Link (http://it.farnell.com/tdk/cga2b3x7r1h104k050bb/condensatore-mlcc-x7r-100nf-50v/dp/2210822?iscrfnonsku=true) |  |  |  |  |  |  | 2390 |  | $0.00 | $0.00 | 04X3230 | Link (http://www.newark.com/tdk/c1005x7r1h104k050bb/ceramic-capacitor-0-1uf-50v-x7r/dp/04X3230?iscrfnonsku=true) |  |  |  |  |  | Link (http://it.rs-online.com/web/p/condensatori-ceramici-multistrato/8847087/)
P8 | Raspberry_Pi_+_Conn |  | w_conn_strip:vasch_strip_20x2 |  | N2540-6002RB | 0 | $0.00 | $0.00 | 1738 |  | $0.00 | $0.00 | MHC40K-ND | Link (http://www.digikey.com/scripts/DkSearch/dksus.dll?WT.z_header=search_go&lang=en) | 584 |  | $0.00 | $0.00 | 9838309 | Link (http://it.farnell.com/3m/n2540-6002rb/header-diritta-40-vie/dp/9838309) |  |  |  |  |  |  | 96 |  | $0.00 | $0.00 | 18M6812 | Link (http://www.newark.com/webapp/wcs/stores/servlet/Search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) |  |  |  |  |  | Link (http://it.rs-online.com/web/c/?searchTerm=N2540-6002RB%20)
C45 | 0.022uf/50V |  | w_smd_cap:c_0402 |  | 0402YC223KAT4A | 0 | $0.00 | $0.00 |  |  |  |  |  |  | 1125 |  | $0.00 | $0.00 | 2070384 | Link (http://it.farnell.com/kemet/c0402c223k4racauto/condensatore-mlcc-x7r-22nf-16v/dp/2070384?iscrfnonsku=true) |  |  |  |  |  |  |  |  |  |  |  | Link (http://www.newark.com/webapp/wcs/stores/servlet/Search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) |  |  |  |  |  | Link (http://it.rs-online.com/web/p/condensatori-ceramici-multistrato/6983188/)
U8 | LAN9514I-JZX |  | project_foot:QFN50P900X900X100-65N |  | LAN9514I-JZX | 0 | $0.00 | $0.00 | 1073 |  | $0.00 | $0.00 | LAN9514I-JZX-ND | Link (http://www.digikey.com/scripts/DkSearch/dksus.dll?WT.z_header=search_go&lang=en) | 2 |  | $0.00 | $0.00 | 2407829 | Link (http://it.farnell.com/webapp/wcs/stores/servlet/Search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) |  |  |  |  |  |  | 2 |  | $0.00 | $0.00 | 69W9526 | Link (http://www.newark.com/webapp/wcs/stores/servlet/Search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) | 9 |  | $0.00 | $0.00 | 798-5248 | Link (http://it.rs-online.com/web/p/controller-ethernet/7985248/)
U4 | LM3489 |  | w_smd_dil:msoic-8 |  | LM3489MM/NOPB | 0 | $0.00 | $0.00 | 9049 |  | $0.00 | $0.00 | LM3489MM/NOPBCT-ND | Link (http://www.digikey.com/product-detail/en/texas-instruments/LM3489MM-NOPB/LM3489MM-NOPBCT-ND/1095944) | 2000 |  | $0.00 | $0.00 | 2436034 | Link (http://it.farnell.com/texas-instruments/lm3489mm-nopb/controllore-buck-pfet-smd-msop8/dp/2436034) |  |  |  |  |  |  | 741 |  | $0.00 | $0.00 | 99K2420 | Link (http://www.newark.com/texas-instruments/lm3489mm-nopb/pfet-buck-controller-msop-8/dp/99K2420) | 15 |  | $0.00 | $0.00 | 655-0589 | Link (http://it.rs-online.com/web/c/?searchTerm=LM3489MM%2FNOPB%20)
D8,D9 | SMBJ5.0A |  | w_smd_diode:do214aa |  | SMBJ5.0A | 0 | $0.00 | $0.00 | 49382 |  | $0.00 | $0.00 | SMBJ5.0ALFCT-ND | Link (http://www.digikey.com/product-detail/en/littelfuse-inc/SMBJ5.0A/SMBJ5.0ALFCT-ND/285951) | 10613 |  | $0.00 | $0.00 | 2097845 | Link (http://it.farnell.com/bourns/smbj5-0a/diodo-tvs-5v-600w-smb/dp/2097845) |  |  |  |  |  |  |  |  |  |  |  |  |  |  |  |  |  | Link (http://it.rs-online.com/web/p/diodi-tvs/6287304/)
D2,D3 | BAS16D |  | w_smd_diode:sod123 |  | BAS16D-E3-08 | 0 | $0.00 | $0.00 |  |  |  |  |  | Link (http://www.digikey.com/scripts/DkSearch/dksus.dll?WT.z_header=search_go&lang=en) |  |  |  |  |  |  |  |  |  |  |  |  |  |  |  |  |  | Link (http://www.newark.com/webapp/wcs/stores/servlet/Search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) |  |  |  |  |  | Link (http://it.rs-online.com/web/c/?searchTerm=BAS16D-E3-08%20)
J1 | OneBank |  | project_foot:ASP-129637-13 |  | ASP-129637-13 | 0 | $0.00 | $0.00
C46,C47,C49,C50 | 15pf/50V |  | w_smd_cap:c_0402 |  | GRM1555C1H150JA01D | 0 | $0.00 | $0.00 | 1413352 |  | $0.00 | $0.00 | 490-5888-1-ND | Link (http://www.digikey.com/product-detail/en/murata-electronics-north-america/GRM1555C1H150JA01D/490-5888-1-ND/3315234) | 24240 |  | $0.00 | $0.00 | 2218840 | Link (http://it.farnell.com/murata/grm1555c1h150ja01d/condens-mlcc-c0g-np0-15pf-50v/dp/2218840) |  |  |  |  |  |  | 19780 |  | $0.00 | $0.00 | 48W5742 | Link (http://www.newark.com/webapp/wcs/stores/servlet/Search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) | 1000 |  | $0.00 | $0.00 | 790-2758 | Link (http://it.rs-online.com/web/c/?searchTerm=GRM1555C1H150JA01D%20)
Q4,Q5 | DMG1012T |  | project_foot:SOT523 |  | DMG1012T-7 | 0 | $0.00 | $0.00 | 231192 |  | $0.00 | $0.00 | DMG1012T-7DICT-ND | Link (http://www.digikey.com/product-detail/en/diodes-incorporated/DMG1012T-7/DMG1012T-7DICT-ND/2181232) | 927 |  | $0.00 | $0.00 | 2543524 | Link (http://it.farnell.com/diodes-inc/dmg1012t-7/mosfet-ca-n-20v-sot-523/dp/2543524) |  |  |  |  |  |  | 767 |  | $0.00 | $0.00 | 82Y6555 | Link (http://www.newark.com/webapp/wcs/stores/servlet/Search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) | 4700 |  | $0.00 | $0.00 | 751-4064 | Link (http://it.rs-online.com/web/p/transistor-mosfet/7514064/)
R57-R60 | 75R |  | w_smd_resistors:r_0402 |  | ERJ-2RKF75R0X | 0 | $0.00 | $0.00 | 457782 |  | $0.00 | $0.00 | P75.0LCT-ND | Link (http://www.digikey.com/product-detail/en/panasonic-electronic-components/ERJ-2RKF75R0X/P75.0LCT-ND/194513) | 25580 |  | $0.00 | $0.00 | 2059111 | Link (http://it.farnell.com/panasonic-electronic-components/erj2rkf75r0x/res-film-spesso-75r-1-0-1w-0402/dp/2059111) |  |  |  |  |  |  | 10803 |  | $0.00 | $0.00 | 73T6540 | Link (http://www.newark.com/panasonic-electronic-components/erj-2rkf75r0x/res-thick-film-75r-1-0-063w-0402/dp/73T6540) | 1 |  | $0.00 | $0.00 | 732-5606 | Link (http://it.rs-online.com/web/c/?searchTerm=ERJ-2RKF75R0X%20)
D6 | LED RED |  | w_smd_leds:Led_0603 |  | HT-191USD-5313 | 0 | $0.00 | $0.00
P2 | Industrial Power Screw Terminal |  | project_foot:796644-2 |  | 571-796644-2 | 0 | $0.00 | $0.00 | 1182 |  | $0.00 | $0.00 | A98248-ND | Link (http://www.digikey.com/scripts/DkSearch/dksus.dll?WT.z_header=search_go&lang=en) |  |  |  |  |  | Link (http://it.farnell.com/webapp/wcs/stores/servlet/Search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)
D5 | LED GREEN |  | w_smd_leds:Led_0603 |  | HT-191YG-5310 | 0 | $0.00 | $0.00
Q1 | DMG2305UX |  | w_smd_trans:sot23 |  | DMG2305UX-7 | 0 | $0.00 | $0.00 | 83137 |  | $0.00 | $0.00 | DMG2305UX-7DICT-ND | Link (http://www.digikey.com/product-detail/en/diodes-incorporated/DMG2305UX-7/DMG2305UX-7DICT-ND/4340665) | 1565 |  | $0.00 | $0.00 | 2543533 | Link (http://it.farnell.com/diodes-inc/dmg2305ux-7/mosfet-ca-p-20v-sot-23-3/dp/2543533) |  |  |  |  |  |  | 1565 |  | $0.00 | $0.00 | 82Y6564 | Link (http://www.newark.com/webapp/wcs/stores/servlet/Search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) | 1600 |  | $0.00 | $0.00 | 827-0452 | Link (http://it.rs-online.com/web/p/transistor-mosfet/8270452/)
L1,L2 | 4.7uH/2A/107mR |  | Inductors:Inductor_Taiyo-Yuden_MD-4040 |  | MDWK4040T4R7MM | 0 | $0.00 | $0.00 | 550 |  | $0.00 | $0.00 | 587-4451-1-ND | Link (http://www.digikey.com/product-detail/en/taiyo-yuden/MDWK4040T4R7MM/587-4451-1-ND/5880041) |  |  |  |  |  |  |  |  |  |  |  |  |  |  |  |  |  | Link (http://www.newark.com/webapp/wcs/stores/servlet/Search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)
C7,C10 | 0.1uf/50V |  | w_smd_resistors:r_0402 |  | GRM155R71H104KE14J | 0 | $0.00 | $0.00 | 4873 |  | $0.00 | $0.00 | 490-13342-1-ND | Link (http://www.digikey.com/product-detail/en/murata-electronics-north-america/GRM155R71H104KE14J/490-13342-1-ND/5973352) |  |  |  |  |  | Link (http://it.farnell.com/tdk/cga2b3x7r1h104k050bb/condensatore-mlcc-x7r-100nf-50v/dp/2210822?iscrfnonsku=true) |  |  |  |  |  |  | 2390 |  | $0.00 | $0.00 | 04X3230 | Link (http://www.newark.com/tdk/c1005x7r1h104k050bb/ceramic-capacitor-0-1uf-50v-x7r/dp/04X3230?iscrfnonsku=true) |  |  |  |  |  | Link (http://it.rs-online.com/web/p/condensatori-ceramici-multistrato/8847087/)
C53 | C |  | w_smd_cap:c_0402 |  | - | 0 | $0.00 | $0.00
R18,R19,R21-R24 | 10k |  | w_smd_resistors:r_0402 |  | ERJ-2GEJ103X | 0 | $0.00 | $0.00 | 4213026 |  | $0.00 | $0.00 | P10KJCT-ND | Link (http://www.digikey.com/product-detail/en/panasonic-electronic-components/ERJ-2GEJ103X/P10KJCT-ND/146734) | 55245 |  | $0.00 | $0.00 | 2059239 | Link (http://it.farnell.com/panasonic-electronic-components/erj2gej103x/res-film-spesso-10k-5-0-1w-0402/dp/2059239) |  |  |  |  |  |  | 3111 |  | $0.00 | $0.00 | 65T8248 | Link (http://www.newark.com/panasonic-electronic-components/erj-2gej103x/res-thick-film-10k-5-0-1w-0402/dp/65T8248) |  |  |  |  |  | Link (http://it.rs-online.com/web/p/resistori-smd/7324861/)
P1,P3-P7,P14 | TST |  | Measurement_Points:Measurement_Point_Round-SMD-Pad_Small |  | - | 0 | $0.00 | $0.00
U11 | AP2331W |  | w_smd_trans:sot23 |  | AP2331W-7 | 0 | $0.00 | $0.00 | 3630 |  | $0.00 | $0.00 | AP2331W-7DICT-ND | Link (http://www.digikey.com/product-detail/en/diodes-incorporated/AP2331W-7/AP2331W-7DICT-ND/4251580) |  |  |  |  |  |  |  |  |  |  |  |  |  |  |  |  |  |  | 1900 |  | $0.00 | $0.00 | 828-7665 | Link (http://it.rs-online.com/web/p/switch-di-potenza-intelligenti/8287665/)
C6,C9,C13,C14 | 10uf/10V |  | w_smd_cap:c_0805 |  | GRM21BR71A106KE51L | 0 | $0.00 | $0.00 | 2409021 |  | $0.00 | $0.00 | 490-3905-1-ND | Link (http://www.digikey.com/product-detail/en/murata-electronics-north-america/GRM21BR71A106KE51L/490-3905-1-ND/965947) | 42516 |  | $0.00 | $0.00 | 1828828 | Link (http://it.farnell.com/murata/grm21br71a106ke51l/condensatore-mlcc-x7r-10uf-10v/dp/1828828) |  |  |  |  |  |  | 290 |  | $0.00 | $0.00 | 14T3345 | Link (http://www.newark.com/murata/grm21br71a106ke51l/ceramic-capacitor-10uf-10v-x7r/dp/14T3345) | 100 |  | $0.00 | $0.00 | 723-6060 | Link (http://it.rs-online.com/web/c/?searchTerm=GRM21BR71A106KE51L%20)
 |  |  |  |  |  |  |  |  |  | 0 | 0 | 0 |  |  |  | 0 | 0 | 0 |  |  |  | 0 | 0 | 0 |  |  |  | 0 | 0 | 0 |  |  |  | 0 | 0 | 0
 |  |  |  |  |  |  |  |  |  | 0 | 0 | 0 |  |  |  | 0 | 0 | 0 |  |  |  | 0 | 0 | 0 |  |  |  | 0 | 0 | 0 |  |  |  | 0 | 0 | 0
 |  |  |  |  |  |  |  |  |  | 0 | 0 | 0 |  |  |  | 0 | 0 | 0 |  |  |  | 0 | 0 | 0 |  |  |  | 0 | 0 | 0 |  |  |  | 0 | 0 | 0
 |  |  |  |  |  |  |  |  |  | 0 | 0 | 0 |  |  |  | 0 | 0 | 0 |  |  |  | 0 | 0 | 0 |  |  |  | 0 | 0 | 0 |  |  |  | 0 | 0 | 0
 |  |  |  |  |  |  |  |  |  | 0 | 0 | 0 |  |  |  | 0 | 0 | 0 |  |  |  | 0 | 0 | 0 |  |  |  | 0 | 0 | 0 |  |  |  | 0 | 0 | 0
 |  |  |  |  |  |  |  |  |  | 0 | 0 | 0 |  |  |  | 0 | 0 | 0 |  |  |  | 0 | 0 | 0 |  |  |  | 0 | 0 | 0 |  |  |  | 0 | 0 | 0
 |  |  |  |  |  |  |  |  |  | 0 | 0 | 0 |  |  |  | 0 | 0 | 0 |  |  |  | 0 | 0 | 0 |  |  |  | 0 | 0 | 0 |  |  |  | 0 | 0 | 0
 |  |  |  |  |  |  |  |  |  | 0 | 0 | 0 |  |  |  | 0 | 0 | 0 |  |  |  | 0 | 0 | 0 |  |  |  | 0 | 0 | 0 |  |  |  | 0 | 0 | 0
 |  |  |  |  |  |  |  |  |  | 0 | 0 | 0 |  |  |  | 0 | 0 | 0 |  |  |  | 0 | 0 | 0 |  |  |  | 0 | 0 | 0 |  |  |  | 0 | 0 | 0
 |  |  |  |  |  |  |  |  |  | 0 | 0 | 0 |  |  |  | 0 | 0 | 0 |  |  |  | 0 | 0 | 0 |  |  |  | 0 | 0 | 0 |  |  |  | 0 | 0 | 0
 |  |  |  |  |  |  |  |  |  | 0 | 0 | 0 |  |  |  | 0 | 0 | 0 |  |  |  | 0 | 0 | 0 |  |  |  | 0 | 0 | 0 |  |  |  | 0 | 0 | 0
 |  |  |  |  |  |  |  |  |  | 0 | 0 | 0 |  |  |  | 0 | 0 | 0 |  |  |  | 0 | 0 | 0 |  |  |  | 0 | 0 | 0 |  |  |  | 0 | 0 | 0
 |  |  |  |  |  |  |  |  |  | 0 | 0 | 0 |  |  |  | 0 | 0 | 0 |  |  |  | 0 | 0 | 0 |  |  |  | 0 | 0 | 0 |  |  |  | 0 | 0 | 0
 |  |  |  |  |  |  |  |  |  | 0 | 0 | 0 |  |  |  | 0 | 0 | 0 |  |  |  | 0 | 0 | 0 |  |  |  | 0 | 0 | 0 |  |  |  | 0 | 0 | 0
 |  |  |  |  |  |  |  |  |  | 0 | 0 | 0 |  |  |  | 0 | 0 | 0 |  |  |  | 0 | 0 | 0 |  |  |  | 0 | 0 | 0 |  |  |  | 0 | 0 | 0
 |  |  |  |  |  |  |  |  |  | 0 | 0 | 0 |  |  |  | 0 | 0 | 0 |  |  |  | 0 | 0 | 0 |  |  |  | 0 | 0 | 0 |  |  |  | 0 | 0 | 0
 |  |  |  |  |  |  |  |  |  | 0 | 0 | 0 |  |  |  | 0 | 0 | 0 |  |  |  | 0 | 0 | 0 |  |  |  | 0 | 0 | 0 |  |  |  | 0 | 0 | 0
 |  |  |  |  |  |  |  |  |  | 0 | 0 | 0 |  |  |  | 0 | 0 | 0 |  |  |  | 0 | 0 | 0 |  |  |  | 0 | 0 | 0 |  |  |  | 0 | 0 | 0
 |  |  |  |  |  |  |  |  |  | 0 | 0 | 0 |  |  |  | 0 | 0 | 0 |  |  |  | 0 | 0 | 0 |  |  |  | 0 | 0 | 0 |  |  |  | 0 | 0 | 0
 |  |  |  |  |  |  |  |  |  | 0 | 0 | 0 |  |  |  | 0 | 0 | 0 |  |  |  | 0 | 0 | 0 |  |  |  | 0 | 0 | 0 |  |  |  | 0 | 0 | 0
 |  |  |  |  |  |  |  |  |  | 0 | 0 | 0 |  |  |  | 0 | 0 | 0 |  |  |  | 0 | 0 | 0 |  |  |  | 0 | 0 | 0 |  |  |  | 0 | 0 | 0
 |  |  |  |  |  |  |  |  |  | 0 | 0 | 0 |  |  |  | 0 | 0 | 0 |  |  |  | 0 | 0 | 0 |  |  |  | 0 | 0 | 0 |  |  |  | 0 | 0 | 0
 |  |  |  |  |  |  |  |  |  | 0 | 0 | 0 |  |  |  | 0 | 0 | 0 |  |  |  | 0 | 0 | 0 |  |  |  | 0 | 0 | 0 |  |  |  | 0 | 0 | 0
 |  |  |  |  |  |  |  |  |  | 0 | 0 | 0 |  |  |  | 0 | 0 | 0 |  |  |  | 0 | 0 | 0 |  |  |  | 0 | 0 | 0 |  |  |  | 0 | 0 | 0
 |  |  |  |  |  |  |  |  |  | 0 | 0 | 0 |  |  |  | 0 | 0 | 0 |  |  |  | 0 | 0 | 0 |  |  |  | 0 | 0 | 0 |  |  |  | 0 | 0 | 0
 |  |  |  |  |  |  |  |  |  | 0 | 0 | 0 |  |  |  | 0 | 0 | 0 |  |  |  | 0 | 0 | 0 |  |  |  | 0 | 0 | 0 |  |  |  | 0 | 0 | 0
 |  |  |  |  |  |  |  |  |  | 0 | 0 | 0 |  |  |  | 0 | 0 | 0 |  |  |  | 0 | 0 | 0 |  |  |  | 0 | 0 | 0 |  |  |  | 0 | 0 | 0
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
 |  |  |  |  |  |  |  |  |  | 0 | 0 | 0 |  |  |  | 0 | 0 | 0 |  |  |  | 0 | 0 | 0 |  |  |  | 0 | 0 | 0 |  |  |  | 0 | 0 | 0
 |  |  |  |  |  |  |  |  |  | 0 | 0 | 0 |  |  |  | 0 | 0 | 0 |  |  |  | 0 | 0 | 0 |  |  |  | 0 | 0 | 0 |  |  |  | 0 | 0 | 0
