Roboteurs/Pi-104/hardware/RPi PCIe104 OB Compute Mod.pdf

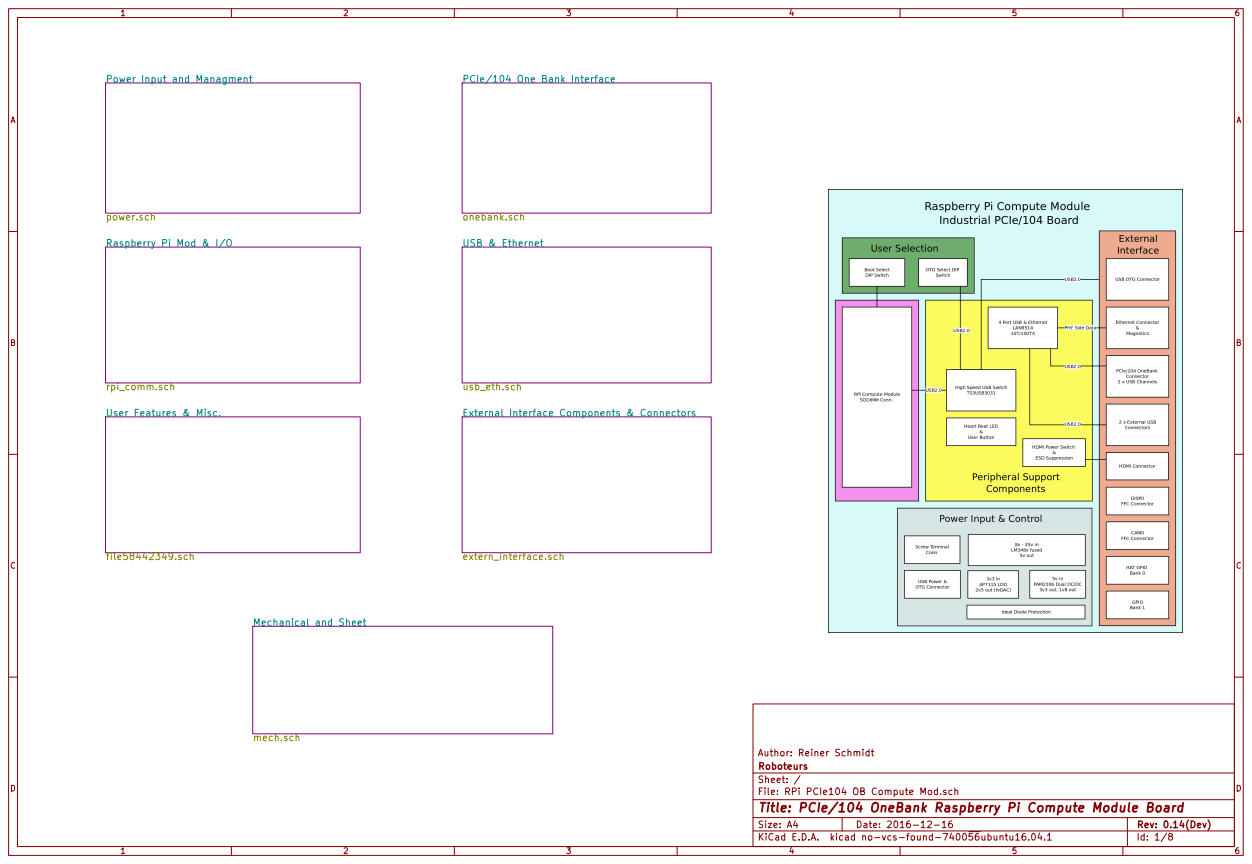
[picture p1: page 1]

Power Input and Managment

PCIe/104 One Bank Interface

onebank.sch USB & Ethernet

rpi_comm.sch User Features & Misc.

External Interface Components & Connectors

File: RPi PCIe104 OB Compute Mod.sch Sheet: / Roboteurs Author: Reiner Schmidt

Id: 1/8 Title: PCIe/104 OneBank Raspberry Pi Compute Module Board

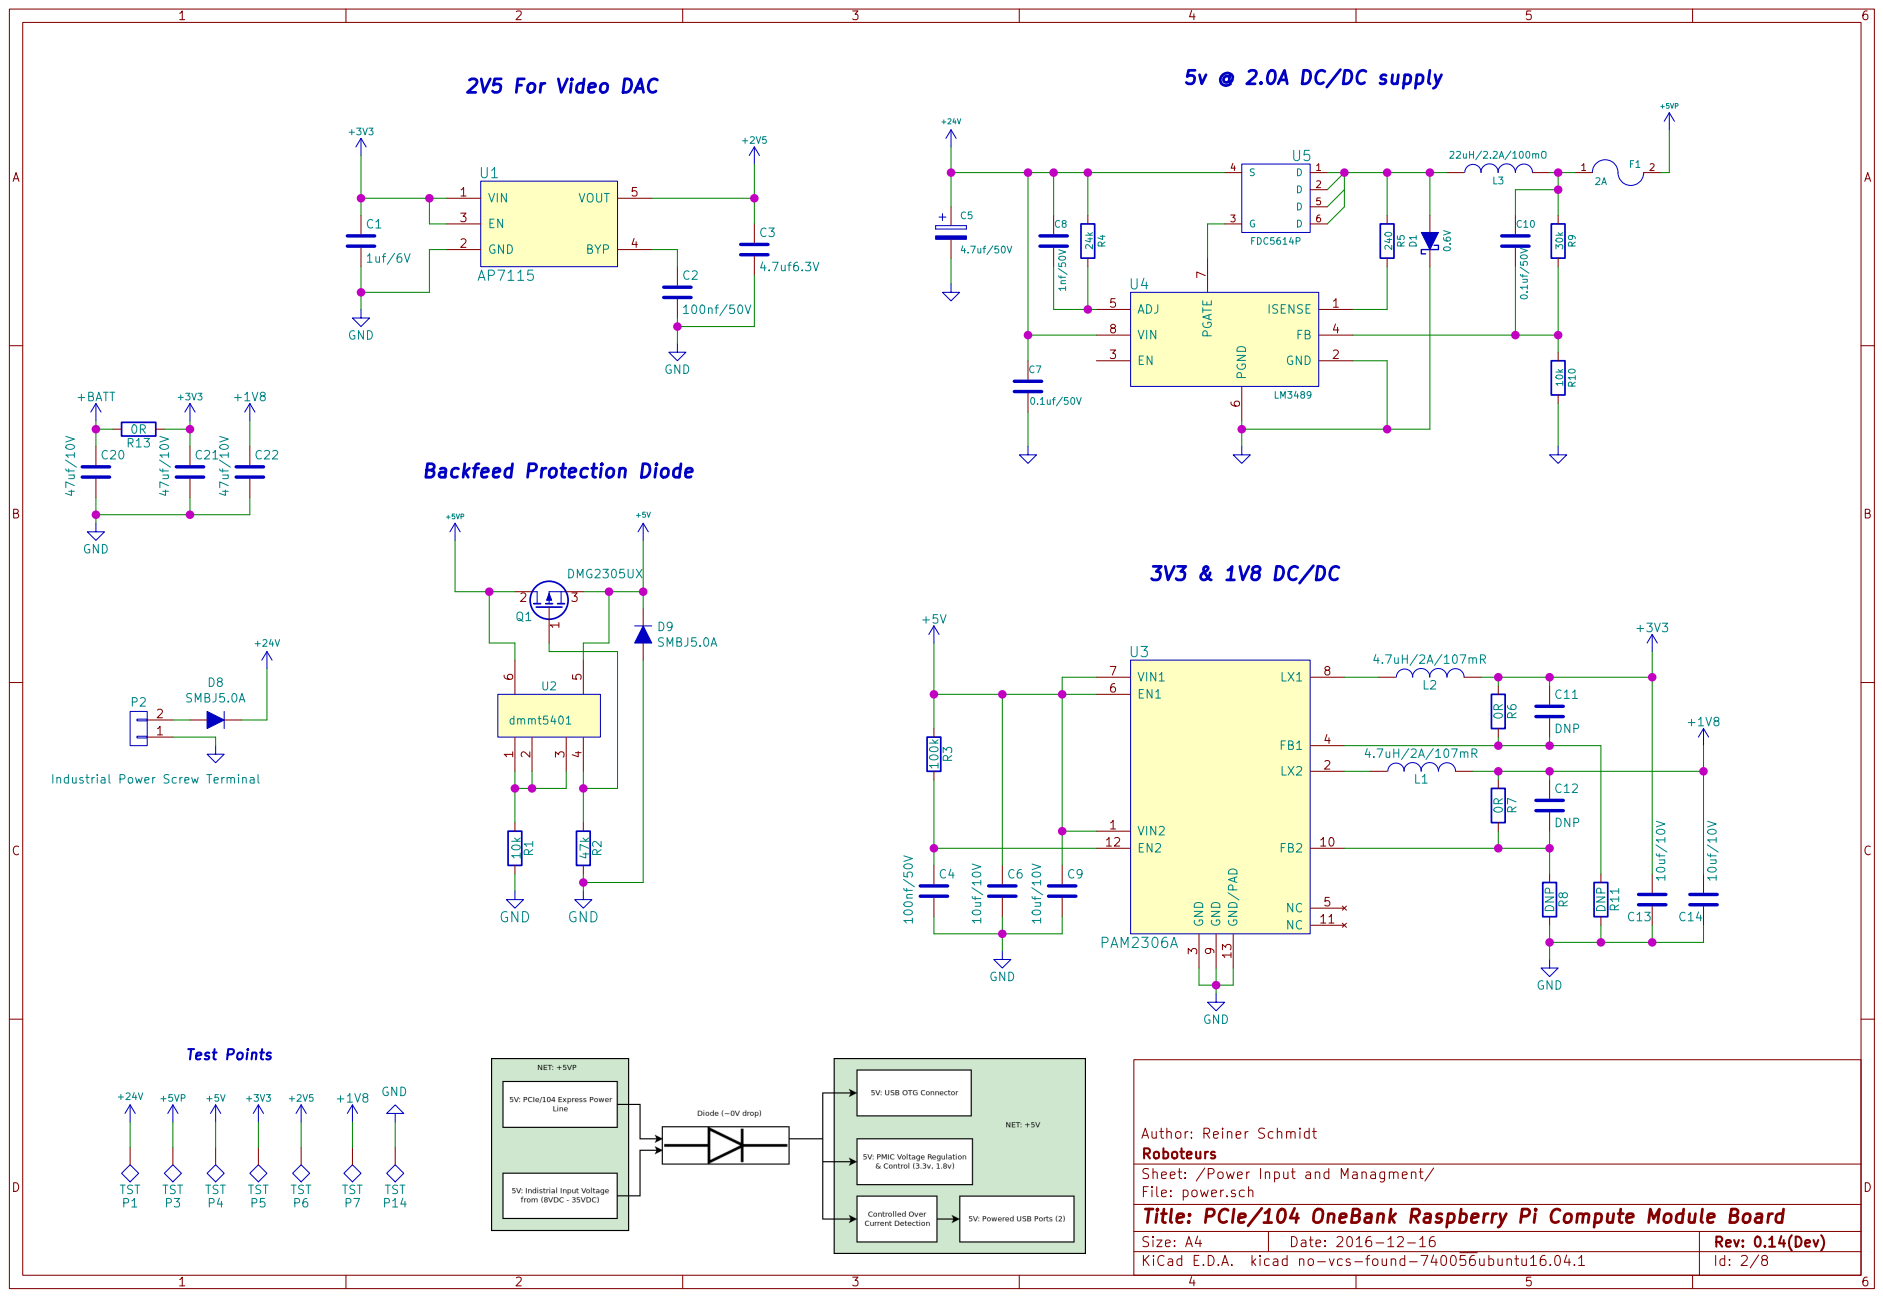
[picture p2: page 2]

Sheet: /Power Input and Managment/ Roboteurs Author: Reiner Schmidt

File: power.sch
Id: 2/8 Title: PCIe/104 OneBank Raspberry Pi Compute Module Board

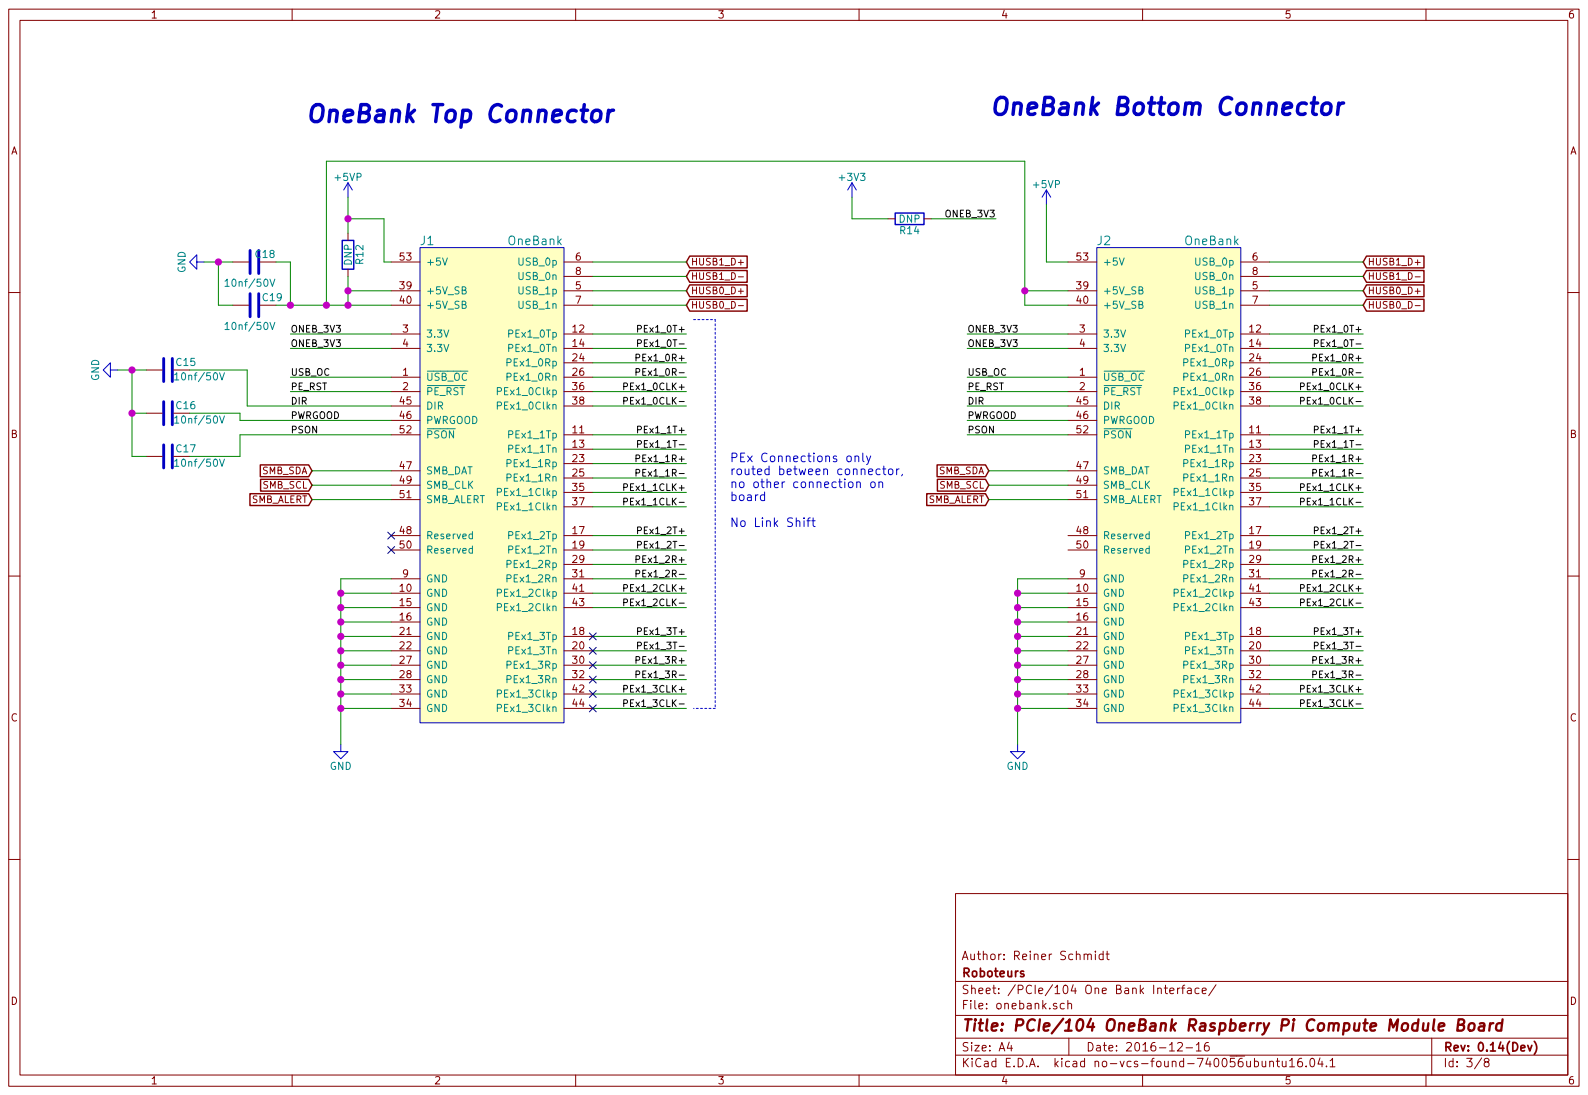
[picture p3: page 3]

File: onebank.sch Sheet: /PCIe/104 One Bank Interface/ Roboteurs Author: Reiner Schmidt

Id: 3/8 Title: PCIe/104 OneBank Raspberry Pi Compute Module Board

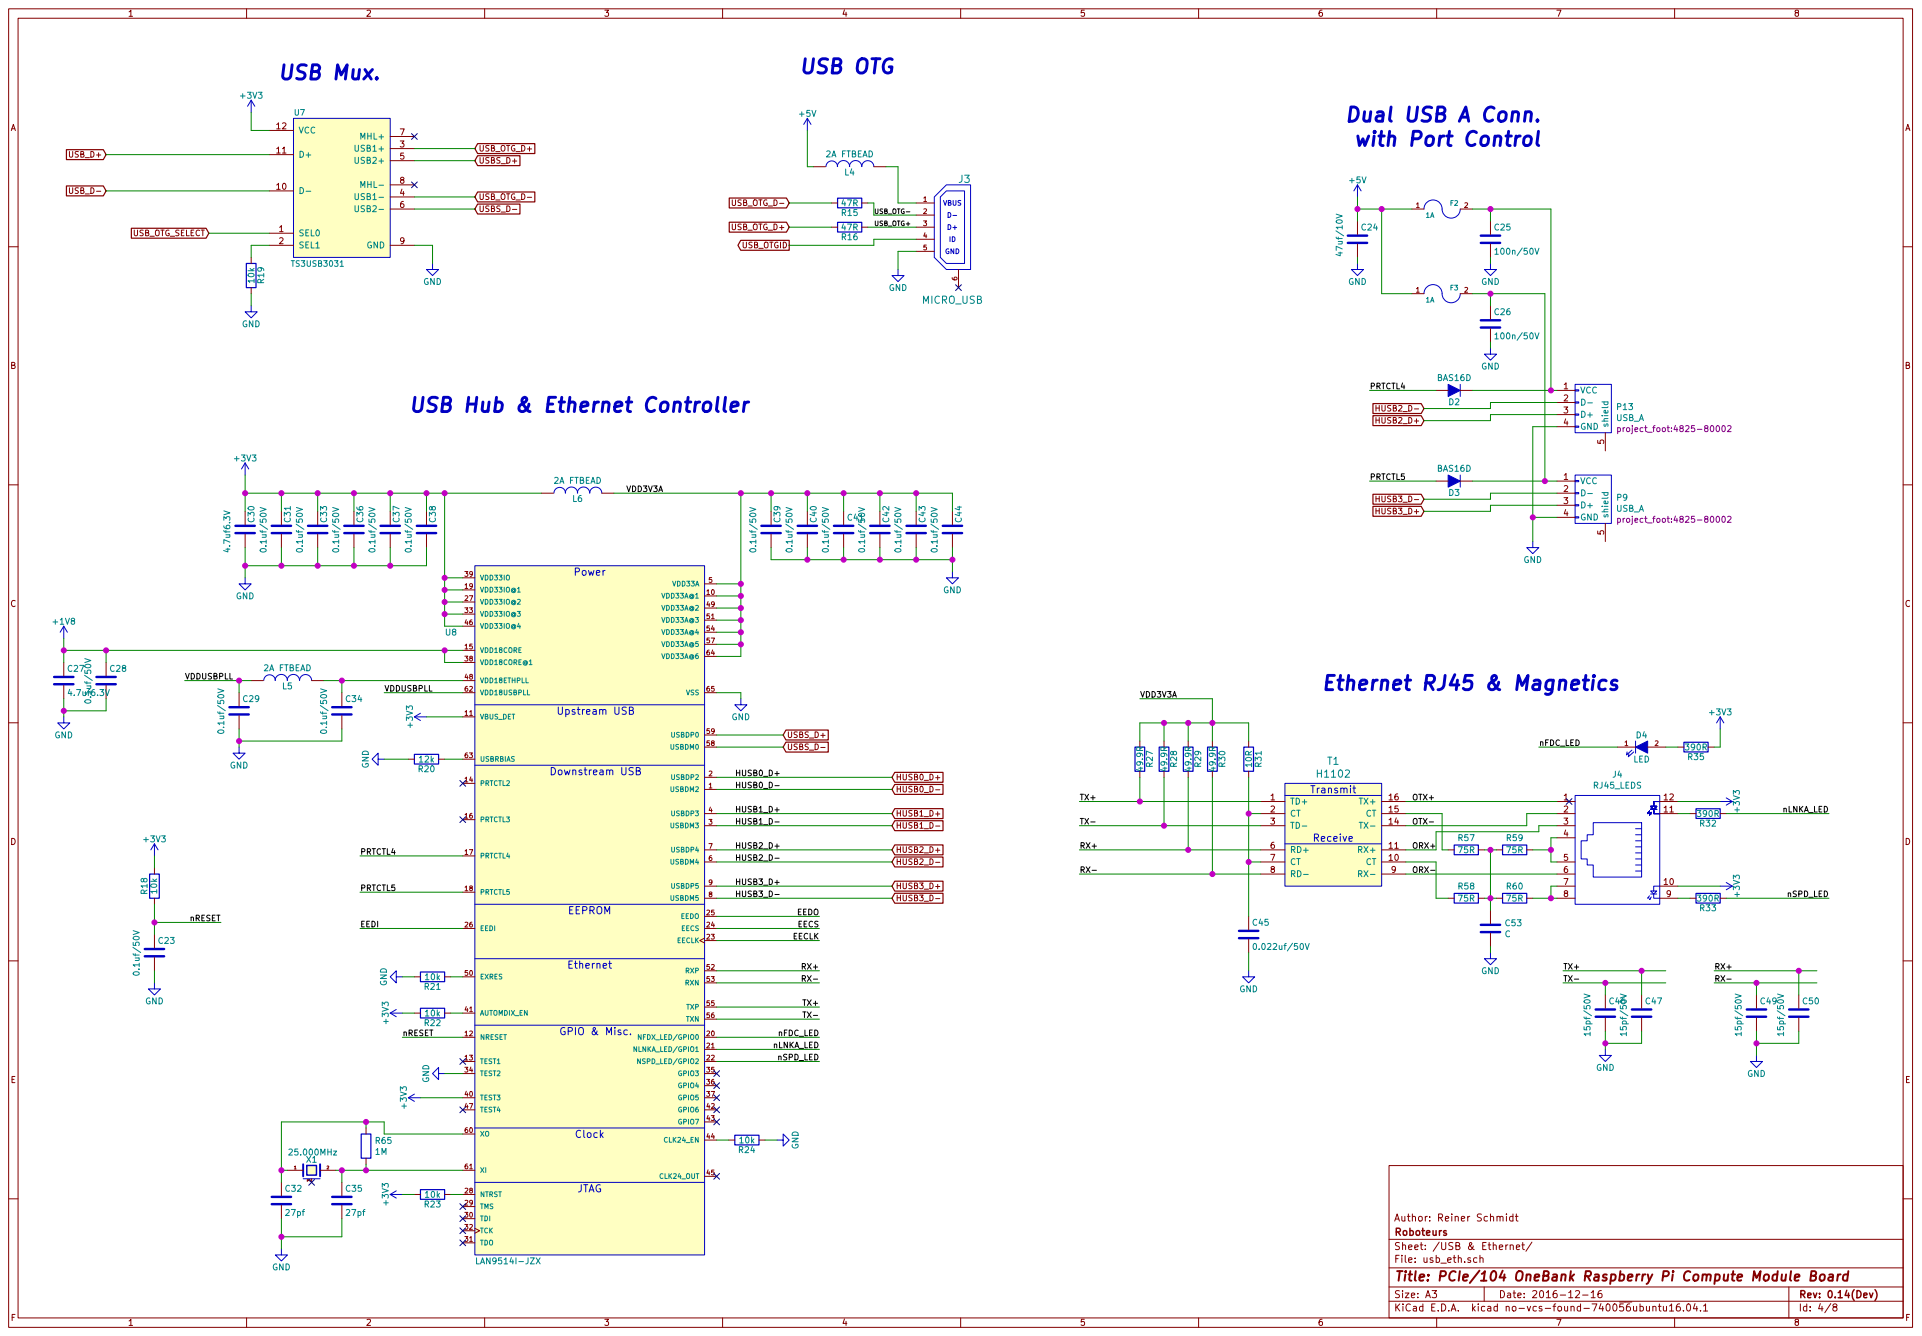
[picture p4: page 4]

USB Hub & Ethernet Controller

RX+ RX- TX+ TX- PRTCTL4 PRTCTL5

File: usb_eth.sch Sheet: /USB & Ethernet/ Roboteurs Author: Reiner Schmidt Clock

Id: 4/8 Title: PCIe/104 OneBank Raspberry Pi Compute Module Board

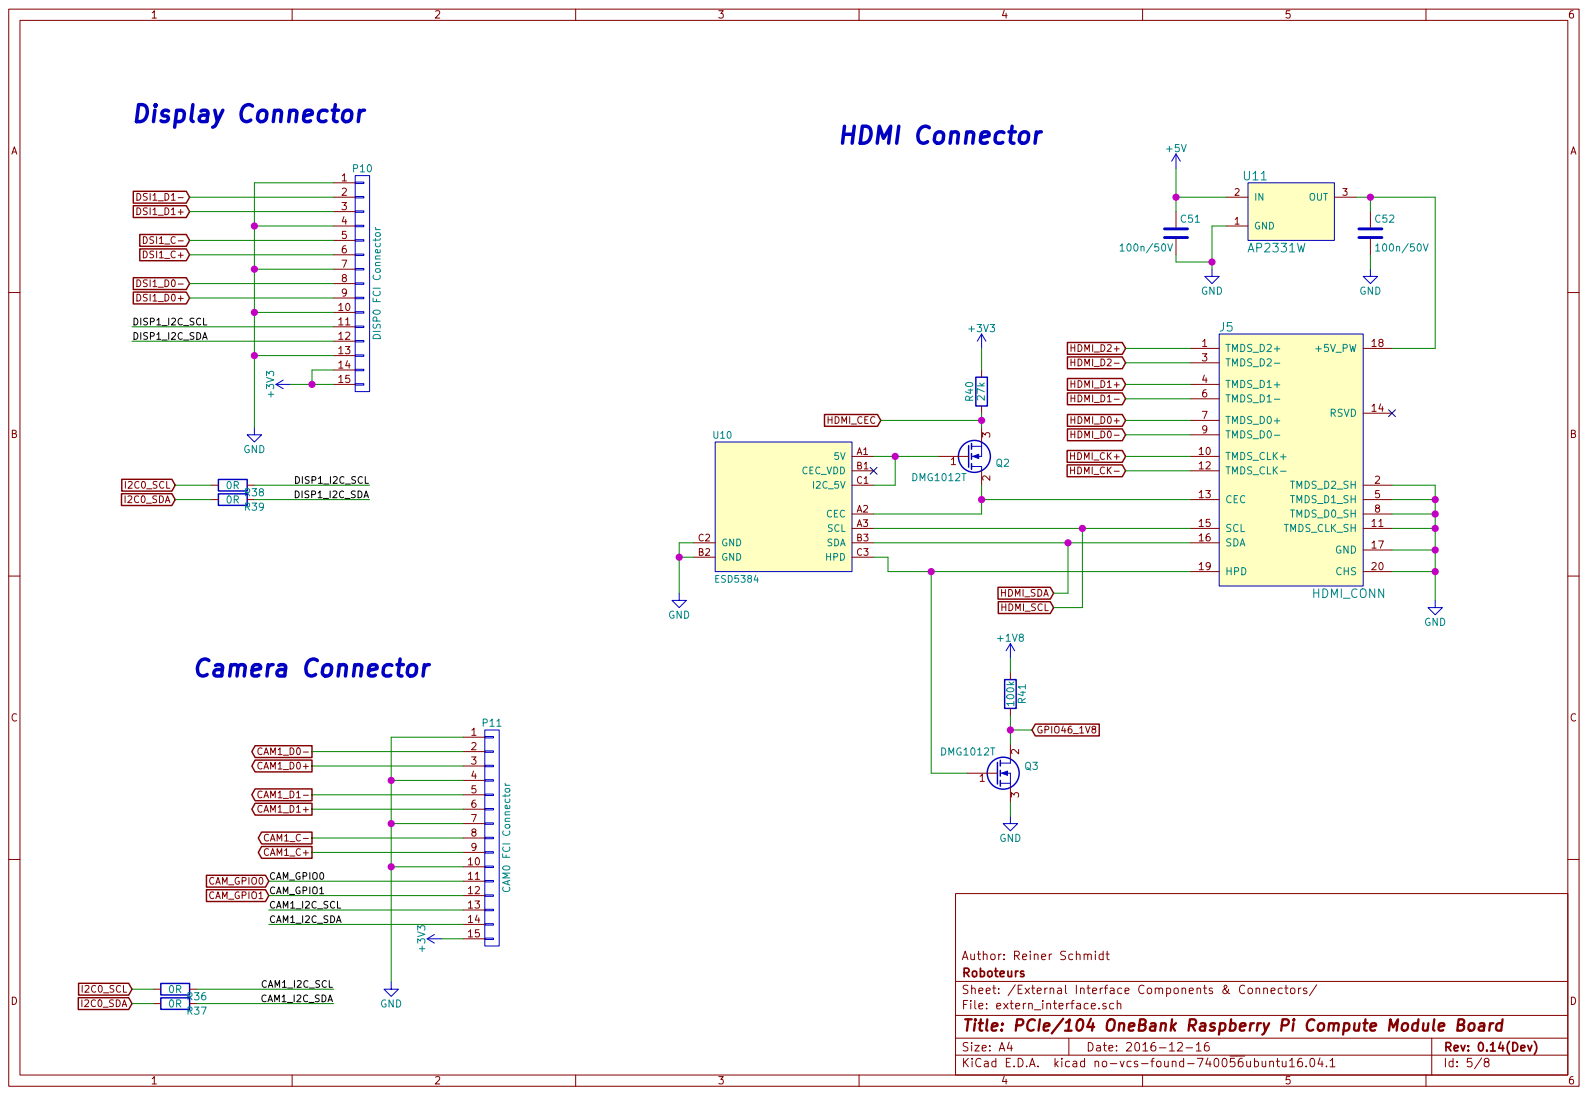
[picture p5: page 5]

Sheet: /External Interface Components & Connectors/ Roboteurs Author: Reiner Schmidt

File: extern_interface.sch
Id: 5/8 Title: PCIe/104 OneBank Raspberry Pi Compute Module Board

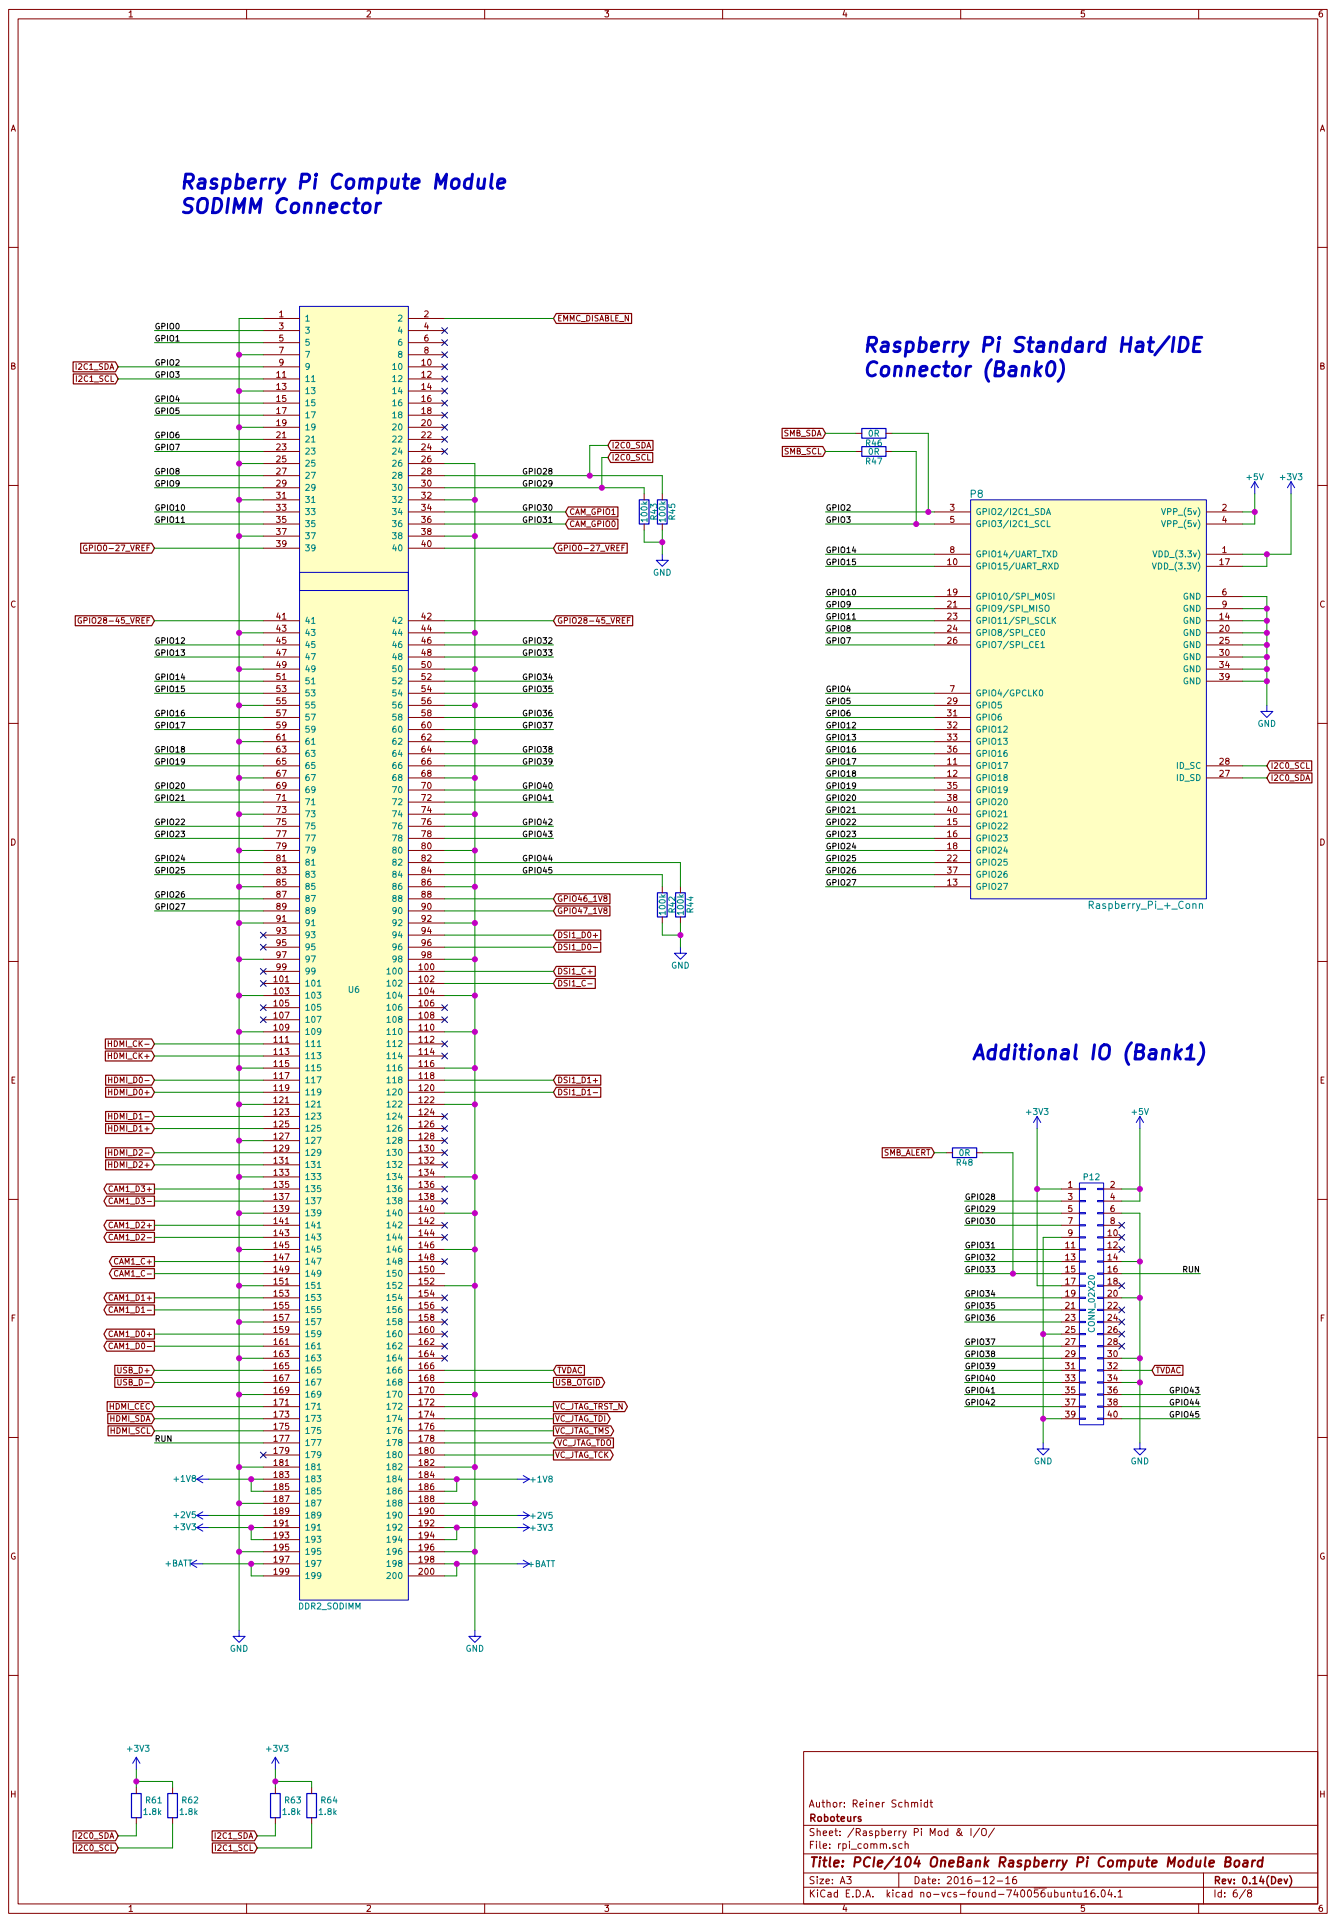
[picture p6: page 6]

Raspberry Pi Compute Module
SODIMM Connector
GPIO0 GPIO1 GPIO2 GPIO3 GPIO4 GPIO5 GPIO6 GPIO7 GPIO8 GPIO9 GPIO10 GPIO11 GPIO0-27_VREF GPIO28-45_VREF GPIO12 GPIO13 GPIO14 GPIO15 GPIO16 GPIO17 GPIO18 GPIO19 GPIO20 GPIO21 GPIO22 GPIO23 GPIO24 GPIO25 GPIO26 GPIO27 HDMI_CK- HDMI_CK+ HDMI_D0- HDMI_D0+ HDMI_D1- HDMI_D1+ HDMI_D2- HDMI_D2+ CAM1_D3+ CAM1_D3- CAM1_D2+ CAM1_D2- CAM1_D1+ CAM1_D1- CAM1_C+ CAM1_C- CAM1_D0+ CAM1_D0- USB_D+ USB_D- HDMI_CEC

15 | 16
17 | 18 20

Sheet: /Raspberry Pi Mod & I/O/ Roboteurs Author: Reiner Schmidt

File: rpi_comm.sch
Id: 6/8 Title: PCIe/104 OneBank Raspberry Pi Compute Module Board

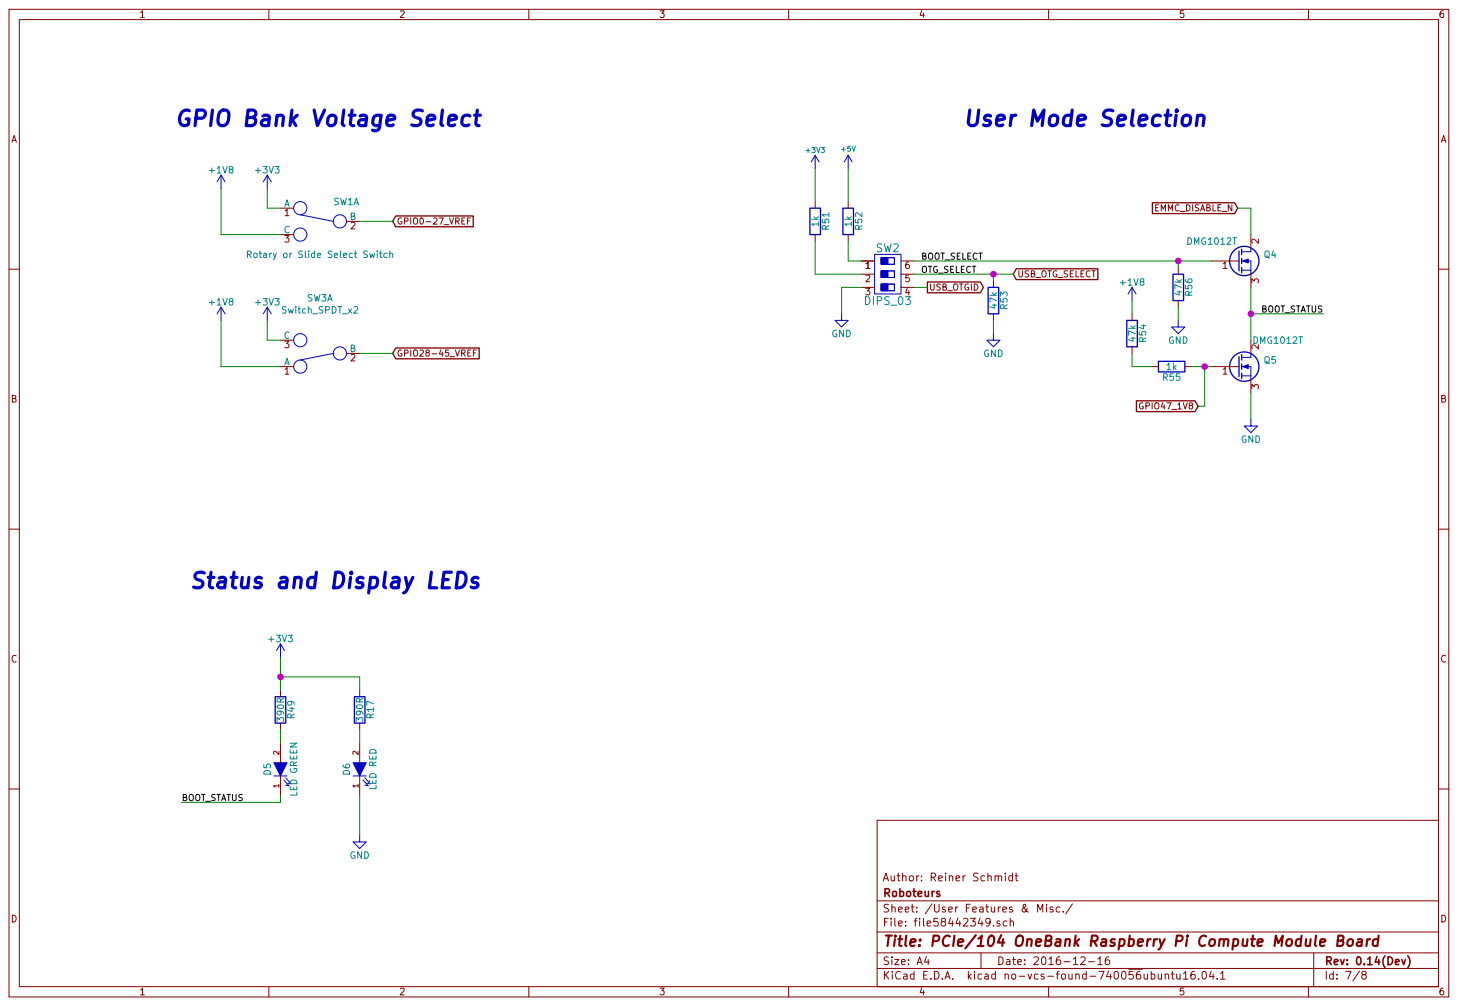
[picture p7: page 7]

+5V GPIO0-27_VREF GPIO28-45_VREF GPIO Bank Voltage Select

Status and Display LEDs

File: file58442349.sch Sheet: /User Features & Misc./ Roboteurs Author: Reiner Schmidt

Id: 7/8 Title: PCIe/104 OneBank Raspberry Pi Compute Module Board

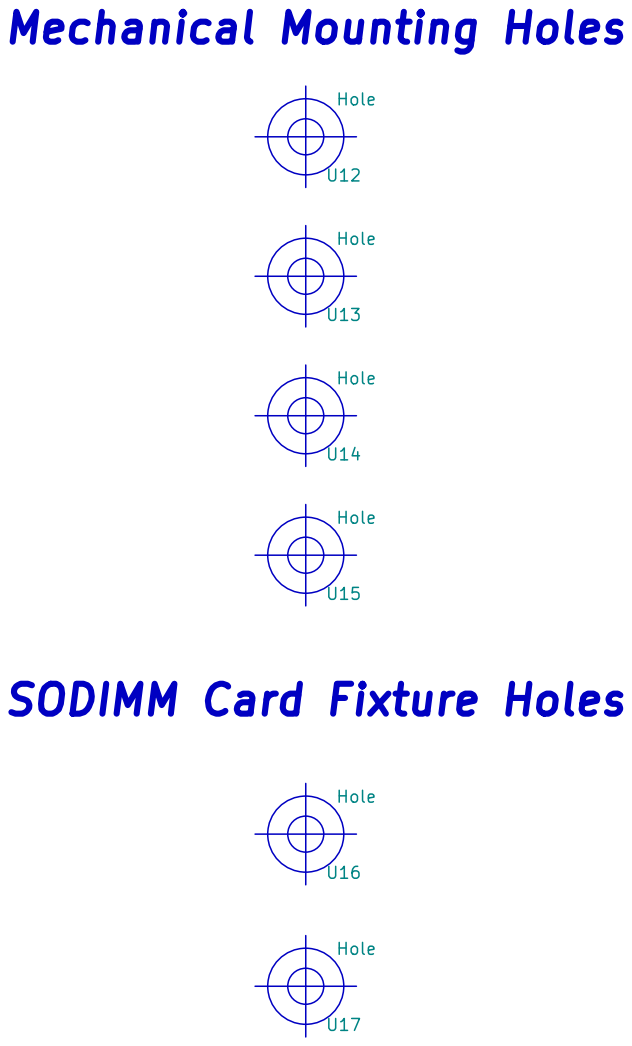
[picture p8: page 8]

File: mech.sch Sheet: /Mechanical and Sheet/ Roboteurs Author: Reiner Schmidt Mechanical Mounting Holes

U12Hole U13Hole U14Hole U15Hole SODIMM Card Fixture Holes

Id: 8/8 Title: PCIe/104 OneBank Raspberry Pi Compute Module Board
