Roboteurs/Pi-104/hardware/RPi PCIe104 OB Compute Mod.kicad_pcb

## KiCad design hardware/RPi PCIe104 OB Compute Mod.kicad_pcb (2016-12-19)

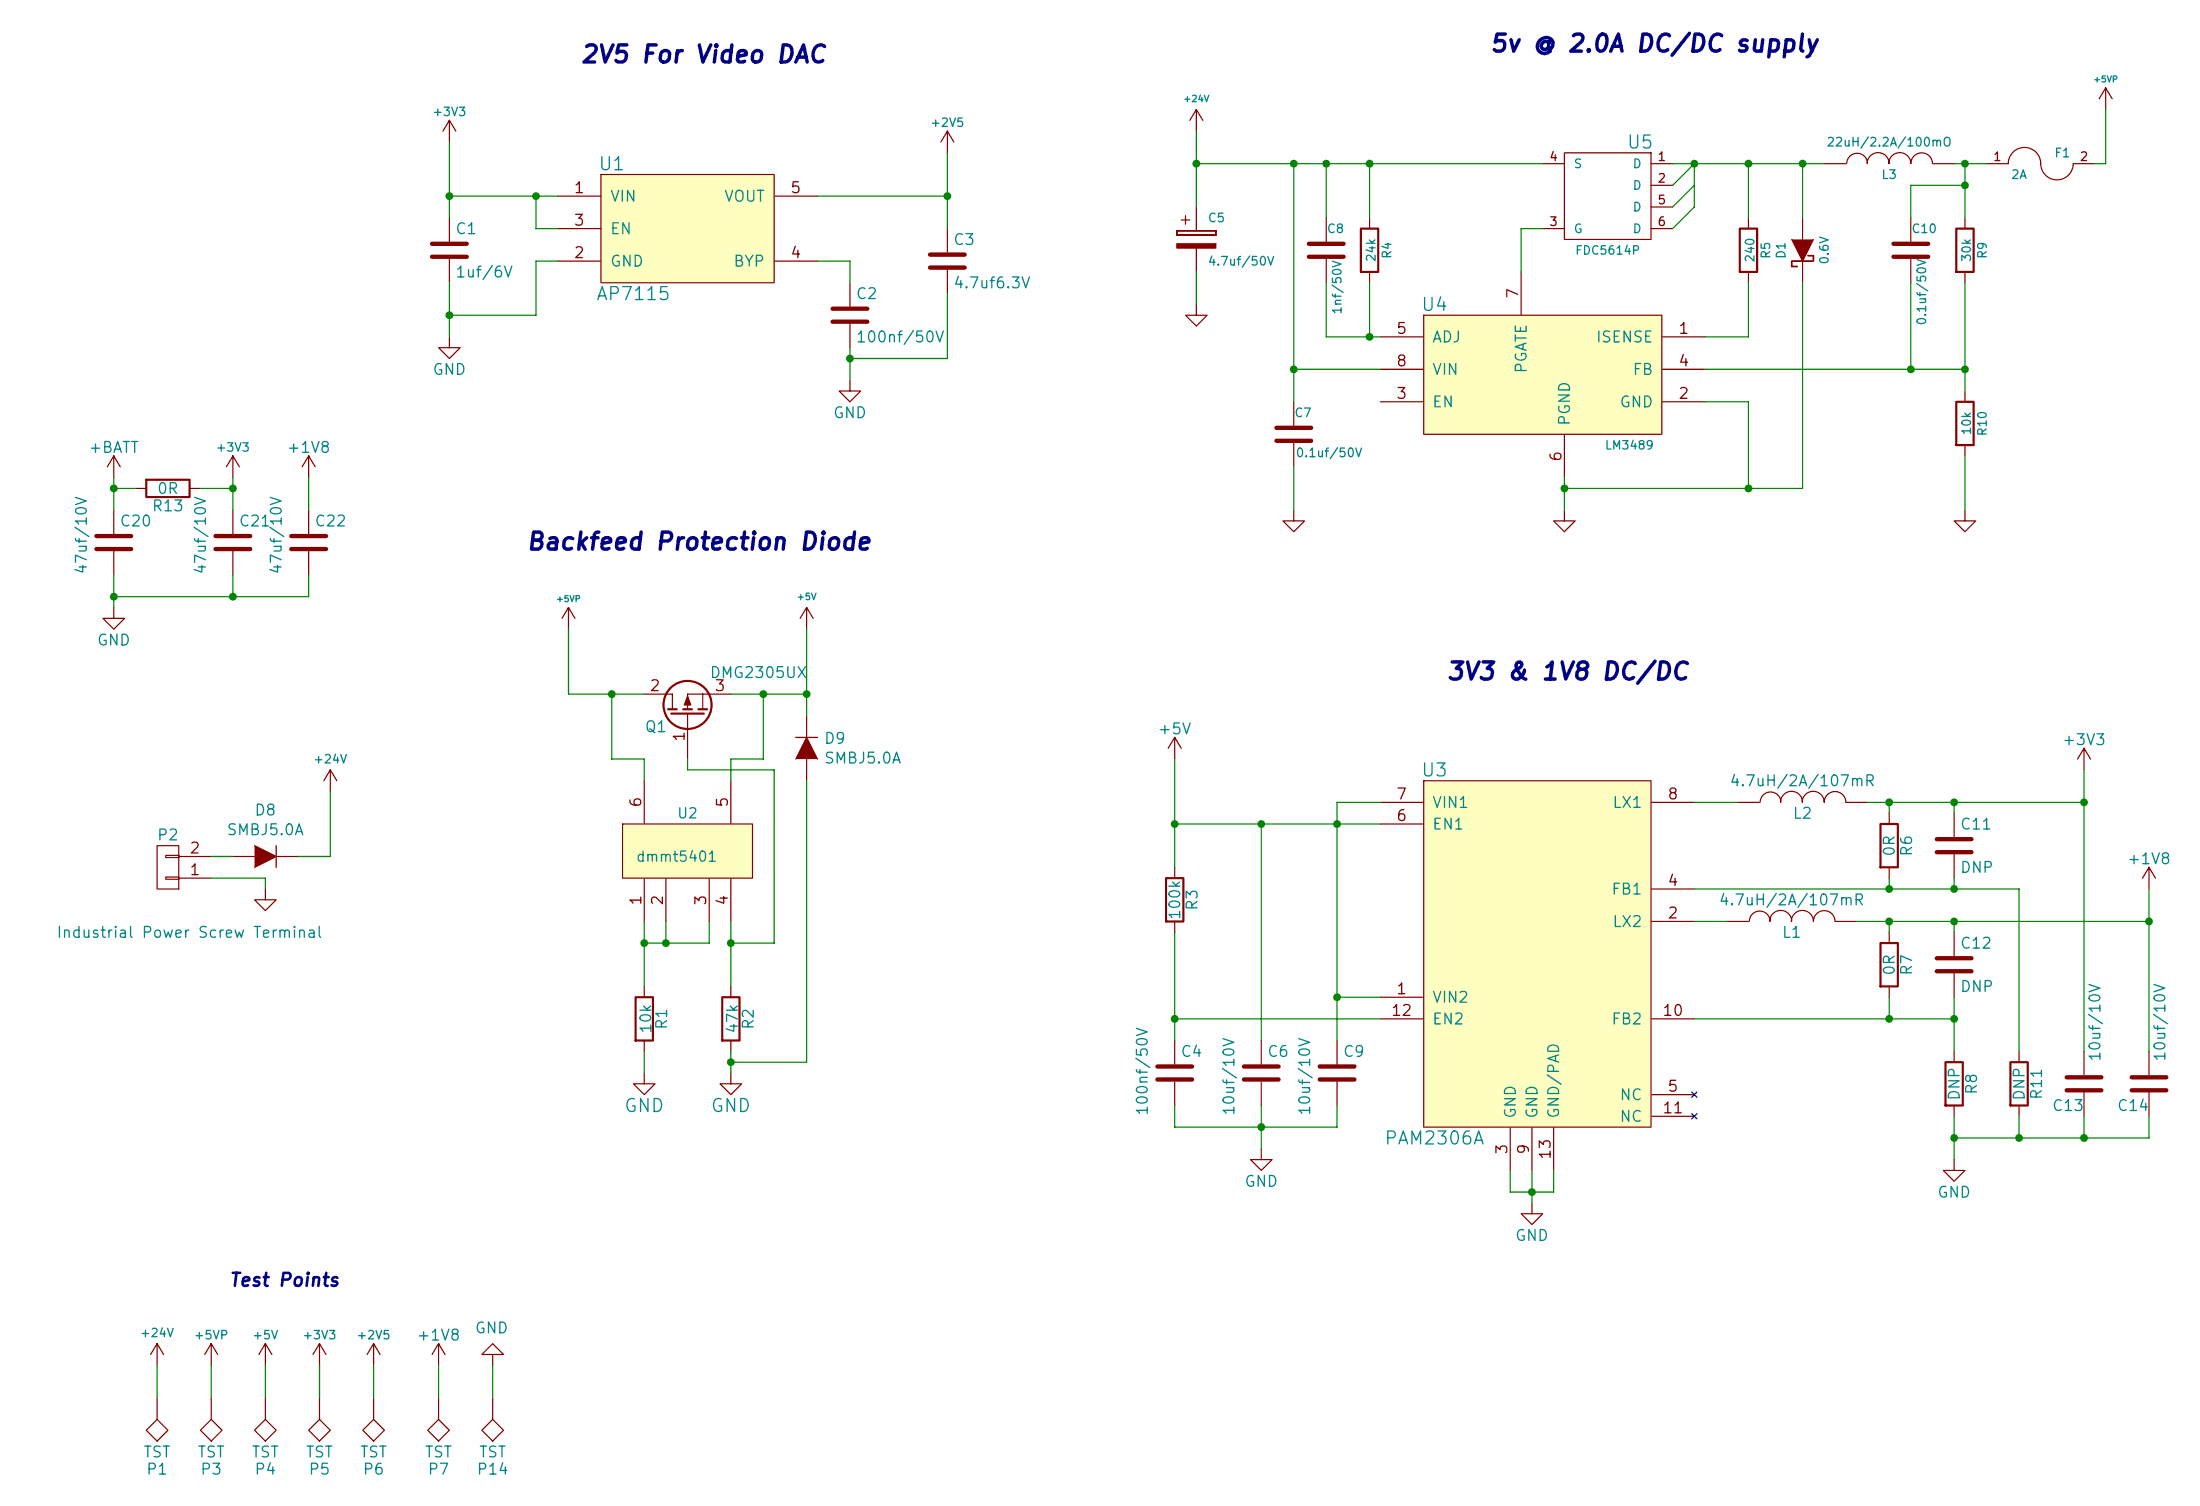
[picture p9: schematic power.sch, PCIe/104 OneBank Raspberry Pi Compute Module Board]

Parts:
C1: 1uf/6V; r_0402; mouser# 81-GRM155R70J105KA2J
C2: 100nf/50V; r_0402; mouser# 81-GRM155R71H104KE4J
C3: 4.7uf6.3V; c_0402; mouser# 581-04026D475KAT2A
C4: 100nf/50V; c_0402; mouser# 81-GRM155R71H104KE4J
C5: 4.7uf/50V; c_elec_4x5.7; Mouser Part No. 647-UWR1H4R7MCL1GB
C6, C9, C13, C14: 10uf/10V; c_0805; mouser# 81-GRM21BR71A106KE51
C7, C10: 0.1uf/50V; r_0402; Mouser Part No. 81-GRM39X104K50D
C8: 1nf/50V; r_0402; Mouser Part No. 81-GCM188R71H102KA7D
C11, C12: DNP; c_0402
C20, C21, C22: 47uf/10V; c_1210; mouser# 80-C1210C476M8P
D1: 0.6V; do214aa; Mouser Part No. 512-MBRS140
D8, D9: SMBJ5.0A; do214aa; mouser# 576-SMBJ5.0A
F1: 2A; r_1206; Mouser Part No. 652-MF-NSMF200-2
L1, L2: 4.7uH/2A/107mR; Inductor_Taiyo-Yuden_MD-4040; mouser# 963-MDWK4040T4R7MM
L3: 22uH/2.2A/100mO; inductor_smd_8x5mm; Mouser Part No. 652-SRN8040-220M
P1, P3, P4, P5, P6, P7, P14: TST; Measurement_Point_Round-SMD-Pad_Small
P2: Industrial Power Screw Terminal; 796644-2; mouser# 571-796644-2
Q1: DMG2305UX; sot23; mouser# 621-DMG2305UX-7
R1: 10k; r_0402; Mouser Part No. 71-CRCW0402-10K-E3
R2: 47k; r_0402; Mouser Part No. 667-ERJ-2RKF4702X
R3: 100k; r_0402; mouser# 667-ERJ-2GEJ104X
R4: 24k; r_0402; Mouser Part No. 71-CRCW0603-24K-E3
R5: 240; r_0603; Mouser Part No. 71-CRCW0603-240-E3
R6, R7, R13: 0R; r_0402; mouser# 71-CRCW0402-0-E3
R8, R11: DNP; r_0402
R9: 30k; r_0402; Mouser Part No. 71-CRCW0603-30K-E3
R10: 10k; r_0402; Mouser Part No. 71-CRCW0603-10K-E3
U1: AP7115; sot323-5; mouser# 621-AP7115-25SEG-7
U2: dmmt5401; sot23-6; Mouser Part No. 621-DMMT5401-7-F
U3: PAM2306A; dfn12; mouser# 621-PAM2306AYPKE
U4: LM3489; msoic-8; Mouser Part No. 926-LM3489MM/NOPB
U5: FDC5614P; sot23-6; Mouser Part No. 512-FDC5614P

Connections:
+1V8: C12.1, C14.1, C22.1, L1.2, P7.1, R7.1; also elsewhere on the board
+2V5: C3.1, P6.1, U1.5 (VOUT); also elsewhere on the board
+3V3: C1.1, C11.1, C13.1, C21.1, L2.2, P5.1, R6.1, R13.1, U1.1 (VIN), U1.3 (EN); also elsewhere on the board
+5V: C6.1, C9.1, D9.1 (K), P4.1, Q1.3 (S), R3.1, U2.5, U3.1 (VIN2), U3.6 (EN1), U3.7 (VIN1); also elsewhere on the board
+5VP: F1.2, P3.1, Q1.2 (D), U2.6; also elsewhere on the board
+24V: C5.1, C7.1, C8.1, D8.1 (K), P1.1, R4.1, U4.8 (VIN), U5.4 (S)
+BATT: C20.1, R13.2; also elsewhere on the board
GND: C1.2, C2.2, C3.2, C4.2, C5.2, C6.2, C7.2, C9.2, C13.2, C14.2, C20.2, C21.2, C22.2, D1.1 (K), D9.2 (A), P2.1, P14.1, R1.2, R2.2, R8.2, R10.2, R11.2, U1.2 (GND), U3.3 (GND), U3.9 (GND), U3.13 (GND/PAD), U4.2 (GND), U4.6 (PGND); also elsewhere on the board
unnamed: C2.1, U1.4 (BYP)
unnamed: C4.1, R3.2, U3.12 (EN2)
unnamed: C8.2, R4.2, U4.5 (ADJ)
unnamed: C10.1, F1.1, L3.2, R9.1
unnamed: C10.2, R9.2, R10.1, U4.4 (FB)
unnamed: C11.2, R6.2, R11.1, U3.4 (FB1)
unnamed: C12.2, R7.2, R8.1, U3.10 (FB2)
unnamed: D1.2 (A), L3.1, R5.1, U5.1 (D), U5.2 (D), U5.6 (D)
unnamed: D8.2 (A), P2.2
unnamed: L1.1, U3.2 (LX2)
unnamed: L2.1, U3.8 (LX1)
unnamed: Q1.1 (G), R2.1, U2.4
unnamed: R1.1, U2.1, U2.2, U2.3
unnamed: R5.2, U4.1 (ISENSE)
unnamed: U4.7 (PGATE), U5.3 (G)

Notes on the sheet:
5v @ 2.0A DC/DC supply
3V3 & 1V8 DC/DC
2V5 For Video DAC
Test Points
Backfeed Protection Diode

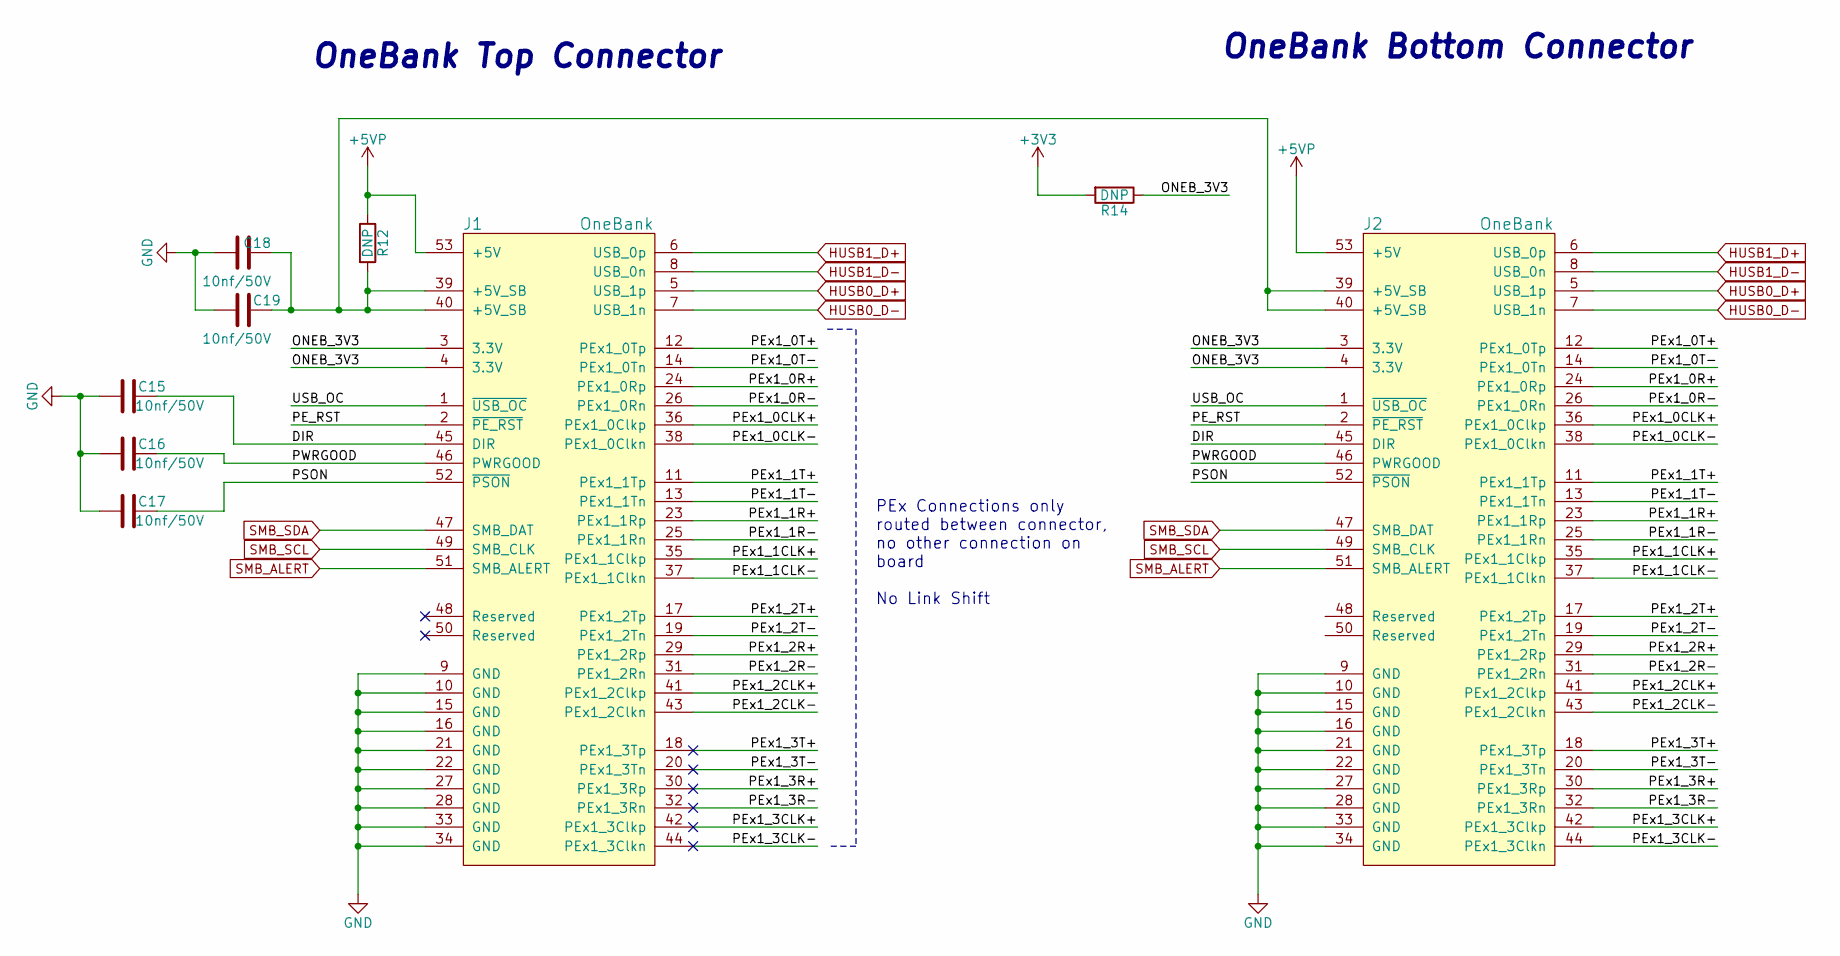
[picture p10: schematic onebank.sch, PCIe/104 OneBank Raspberry Pi Compute Module Board]

Parts:
C15, C16, C17, C18, C19: 10nf/50V; c_0402; mouser# 581-04025C103KAT2A
J1: OneBank; ASP-129637-13
J2: OneBank; ASP-129646-22
R12: DNP; r_0402
R14: DNP; r_0603

Connections:
+3V3: R14.2; also elsewhere on the board
+5VP: J1.53 (+5V), J2.53 (+5V), R12.1; also elsewhere on the board
/PCIe/104 One Bank Interface/DIR: C15.2, J1.45 (DIR), J2.45 (DIR)
/PCIe/104 One Bank Interface/ONEB_3V3: J1.3 (3.3V), J1.4 (3.3V), J2.3 (3.3V), J2.4 (3.3V), R14.1
/PCIe/104 One Bank Interface/PE_RST: J1.2 (~PE_RST), J2.2 (~PE_RST)
/PCIe/104 One Bank Interface/PEx1_0CLK+: J1.36 (PEx1_0Clkp), J2.36 (PEx1_0Clkp)
/PCIe/104 One Bank Interface/PEx1_0CLK-: J1.38 (PEx1_0Clkn), J2.38 (PEx1_0Clkn)
/PCIe/104 One Bank Interface/PEx1_0R+: J1.24 (PEx1_0Rp), J2.24 (PEx1_0Rp)
/PCIe/104 One Bank Interface/PEx1_0R-: J1.26 (PEx1_0Rn), J2.26 (PEx1_0Rn)
/PCIe/104 One Bank Interface/PEx1_0T+: J1.12 (PEx1_0Tp), J2.12 (PEx1_0Tp)
/PCIe/104 One Bank Interface/PEx1_0T-: J1.14 (PEx1_0Tn), J2.14 (PEx1_0Tn)
/PCIe/104 One Bank Interface/PEx1_1CLK+: J1.35 (PEx1_1Clkp), J2.35 (PEx1_1Clkp)
/PCIe/104 One Bank Interface/PEx1_1CLK-: J1.37 (PEx1_1Clkn), J2.37 (PEx1_1Clkn)
/PCIe/104 One Bank Interface/PEx1_1R+: J1.23 (PEx1_1Rp), J2.23 (PEx1_1Rp)
/PCIe/104 One Bank Interface/PEx1_1R-: J1.25 (PEx1_1Rn), J2.25 (PEx1_1Rn)
/PCIe/104 One Bank Interface/PEx1_1T+: J1.11 (PEx1_1Tp), J2.11 (PEx1_1Tp)
/PCIe/104 One Bank Interface/PEx1_1T-: J1.13 (PEx1_1Tn), J2.13 (PEx1_1Tn)
/PCIe/104 One Bank Interface/PEx1_2CLK+: J1.41 (PEx1_2Clkp), J2.41 (PEx1_2Clkp)
/PCIe/104 One Bank Interface/PEx1_2CLK-: J1.43 (PEx1_2Clkn), J2.43 (PEx1_2Clkn)
/PCIe/104 One Bank Interface/PEx1_2R+: J1.29 (PEx1_2Rp), J2.29 (PEx1_2Rp)
/PCIe/104 One Bank Interface/PEx1_2R-: J1.31 (PEx1_2Rn), J2.31 (PEx1_2Rn)
/PCIe/104 One Bank Interface/PEx1_2T+: J1.17 (PEx1_2Tp), J2.17 (PEx1_2Tp)
/PCIe/104 One Bank Interface/PEx1_2T-: J1.19 (PEx1_2Tn), J2.19 (PEx1_2Tn)
/PCIe/104 One Bank Interface/PEx1_3CLK+: J1.42 (PEx1_3Clkp), J2.42 (PEx1_3Clkp)
/PCIe/104 One Bank Interface/PEx1_3CLK-: J1.44 (PEx1_3Clkn), J2.44 (PEx1_3Clkn)
/PCIe/104 One Bank Interface/PEx1_3R+: J1.30 (PEx1_3Rp), J2.30 (PEx1_3Rp)
/PCIe/104 One Bank Interface/PEx1_3R-: J1.32 (PEx1_3Rn), J2.32 (PEx1_3Rn)
/PCIe/104 One Bank Interface/PEx1_3T+: J1.18 (PEx1_3Tp), J2.18 (PEx1_3Tp)
/PCIe/104 One Bank Interface/PEx1_3T-: J1.20 (PEx1_3Tn), J2.20 (PEx1_3Tn)
/PCIe/104 One Bank Interface/PSON: C17.2, J1.52 (~PSON), J2.52 (~PSON)
/PCIe/104 One Bank Interface/PWRGOOD: C16.2, J1.46 (PWRGOOD), J2.46 (PWRGOOD)
/PCIe/104 One Bank Interface/USB_OC: J1.1 (~USB_OC), J2.1 (~USB_OC)
GND: C15.1, C16.1, C17.1, C18.1, C19.1, J1.9 (GND), J1.10 (GND), J1.15 (GND), J1.16 (GND), J1.21 (GND), J1.22 (GND), J1.27 (GND), J1.28 (GND), J1.33 (GND), J1.34 (GND), J2.9 (GND), J2.10 (GND), J2.15 (GND), J2.16 (GND), J2.21 (GND), J2.22 (GND), J2.27 (GND), J2.28 (GND), J2.33 (GND), J2.34 (GND); also elsewhere on the board
HUSB0_D+: J1.5 (USB_1p), J2.5 (USB_1p); also elsewhere on the board
HUSB0_D-: J1.7 (USB_1n), J2.7 (USB_1n); also elsewhere on the board
HUSB1_D+: J1.6 (USB_0p), J2.6 (USB_0p); also elsewhere on the board
HUSB1_D-: J1.8 (USB_0n), J2.8 (USB_0n); also elsewhere on the board
unnamed: C18.2, C19.2, J1.39 (+5V_SB), J1.40 (+5V_SB), J2.39 (+5V_SB), J2.40 (+5V_SB), R12.2
SMB_ALERT: J1.51 (SMB_ALERT), J2.51 (SMB_ALERT); also elsewhere on the board
SMB_SCL: J1.49 (SMB_CLK), J2.49 (SMB_CLK); also elsewhere on the board
SMB_SDA: J1.47 (SMB_DAT), J2.47 (SMB_DAT); also elsewhere on the board

Notes on the sheet:
OneBank Top Connector
OneBank Bottom Connector
PEx Connections only routed between connector, no other connection on board No Link Shift

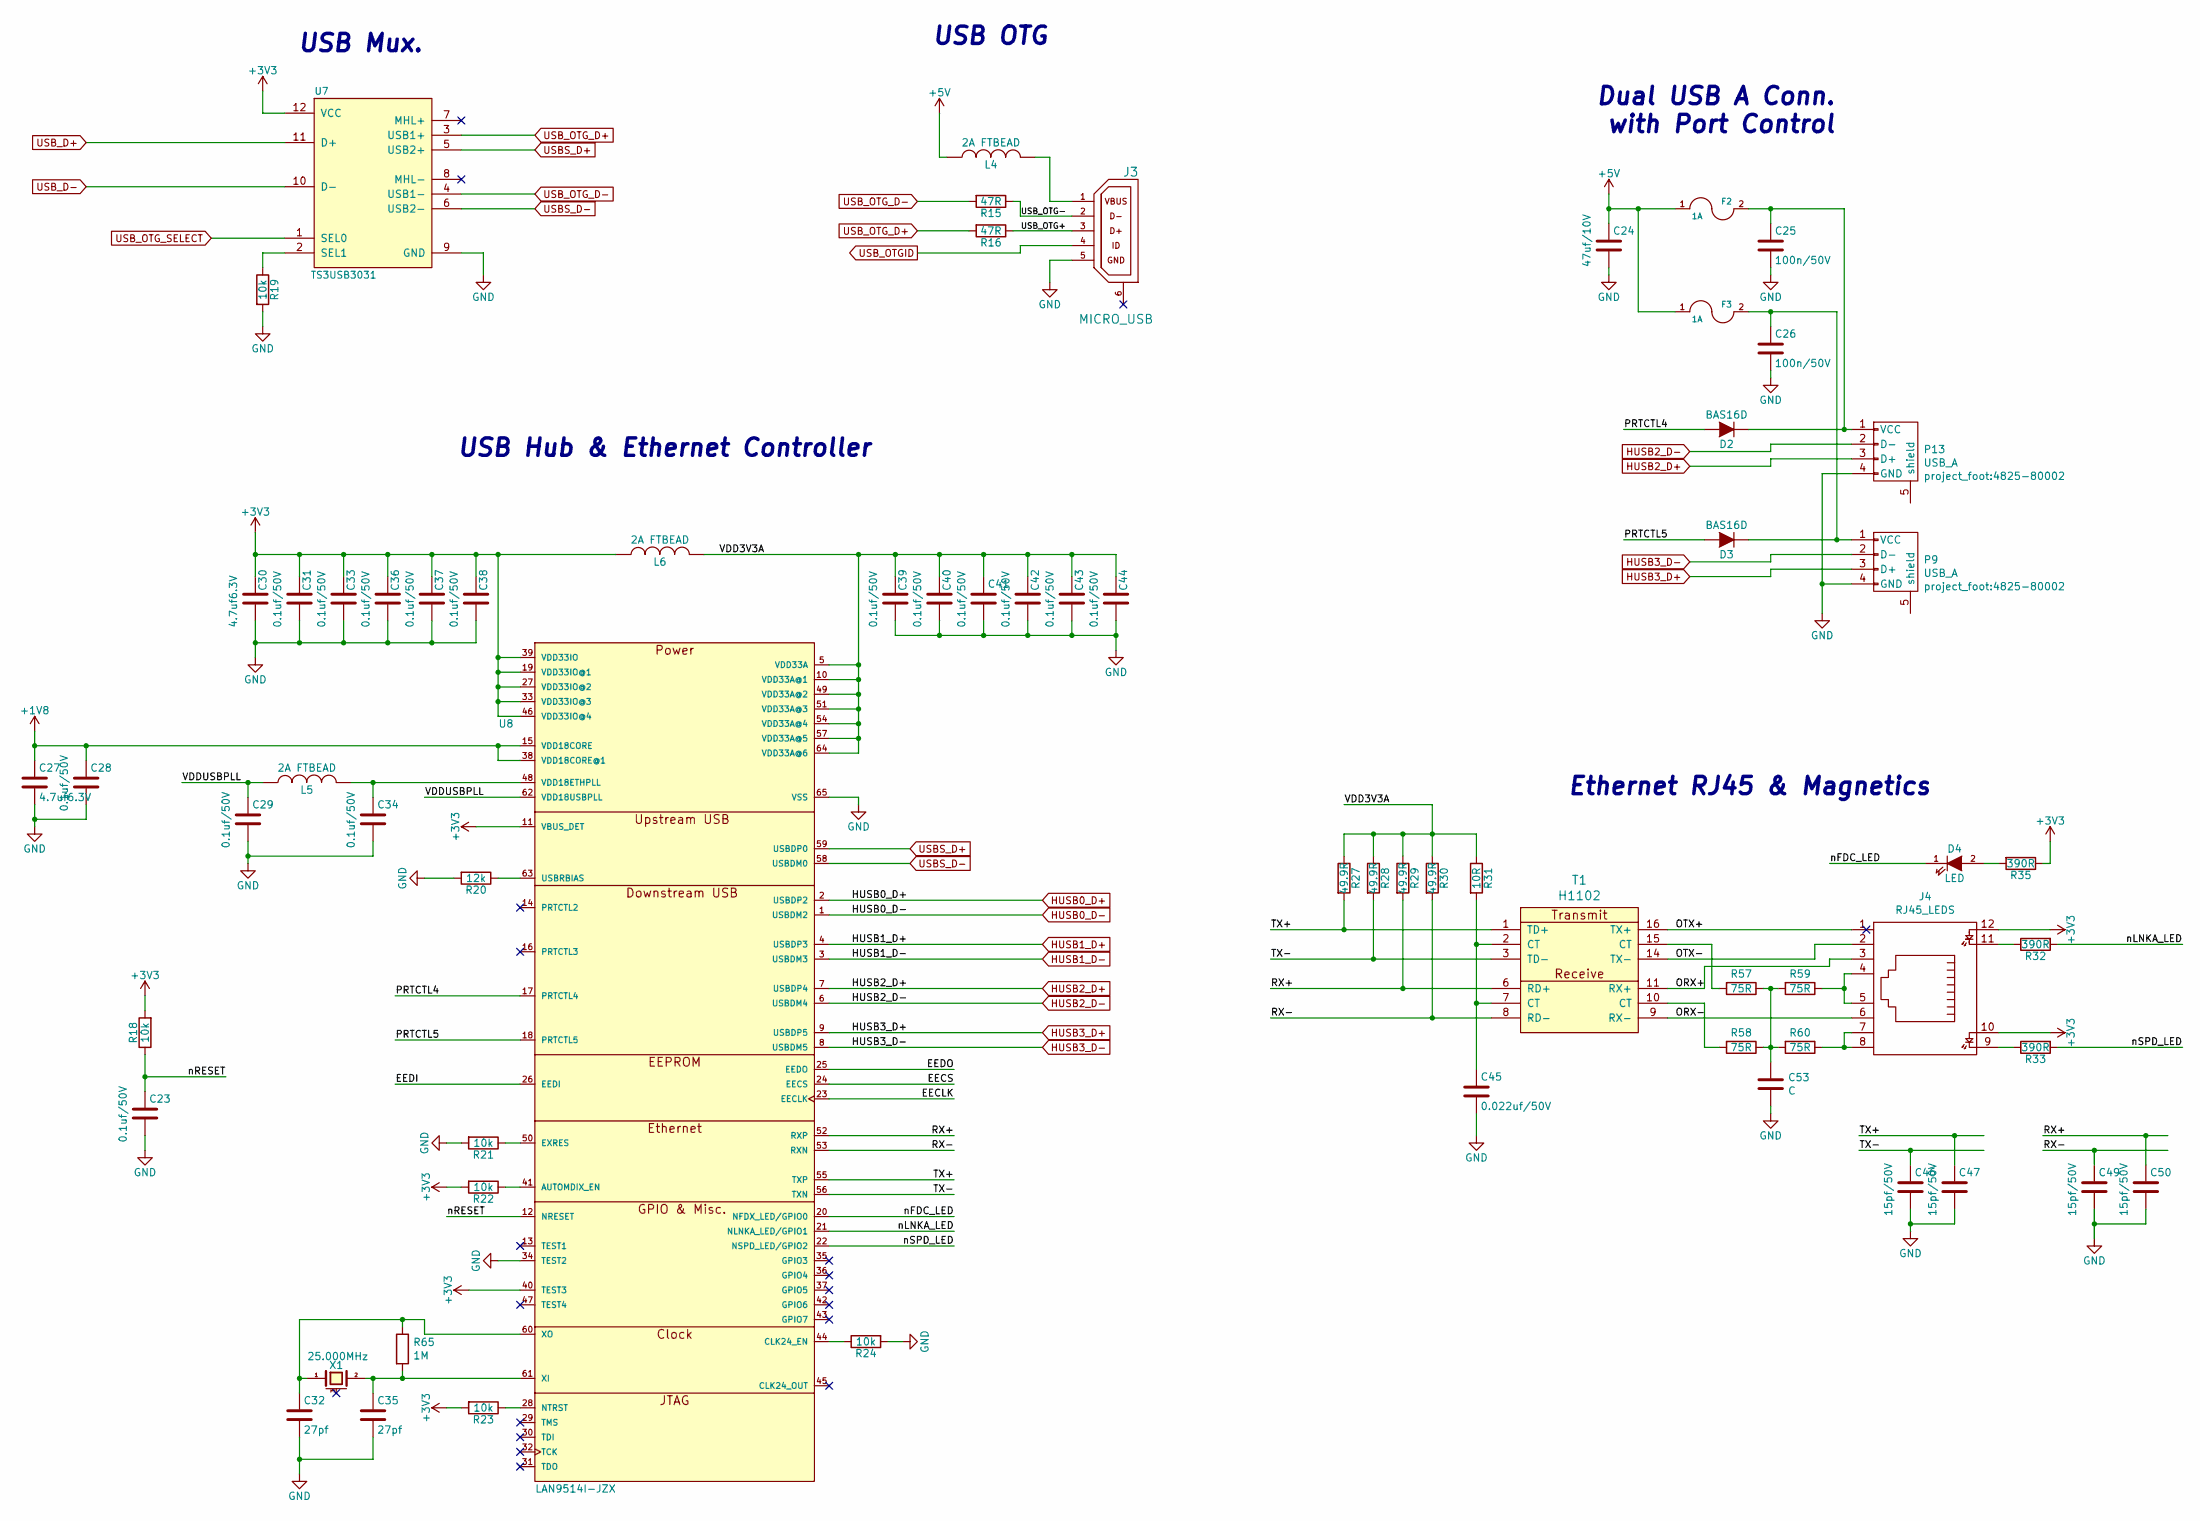
[picture p11: schematic usb_eth.sch, PCIe/104 OneBank Raspberry Pi Compute Module Board]

Parts:
C23, C28, C29, C31, C33, C34, C36, C37, C38, C39, C40, C41, C42, C43, C44: 0.1uf/50V; c_0402; mouser# 81-GRM155R71H104KE4J
C24: 47uf/10V; c_1210; mouser# 80-C1210C476M8P
C25, C26: 100n/50V; c_0402; mouser# 81-GRM155R71H104KE4J
C27, C30: 4.7uf6.3V; c_0402; mouser# 581-04026D475KAT2A
C32, C35: 27pf; c_0402; mouser# 581-04025A270FAT2A
C45: 0.022uf/50V; c_0402; mouser# 581-0402YC223KAT4A
C46, C47, C49, C50: 15pf/50V; c_0402; mouser# 81-GRM1555C1H150JA1D
C53: C; c_0402
D2, D3: BAS16D; sod123; mouser# 78-BAS16D-E3-08
D4: LED; Led_0603; mouser# 743-HT-191YG
F2, F3: 1A; r_1206; Mouser Part No. 652-MF-NSMF200-2
J3: MICRO_USB; conn_usb_B_micro_smd-2; mouser# 538-47346-0001
J4: RJ45_LEDS; RJE72-188; mouser# 523-RJE721881411
L4, L5, L6: 2A FTBEAD; inductor_smd_0603; mouser# 81-BLM18PG121SN1D
P9, P13: USB_A; 4825-80002; mouser# 538-48258-0002
R15, R16: 47R; r_0402; mouser# 754-RG1005P-470DT10
R18, R19, R21, R22, R23, R24: 10k; r_0402; mouser# 667-ERJ-2GEJ103X
R20: 12k; r_0402; mouser# 279-CPF0402B12KE1
R27, R28, R29, R30: 49.9R; r_0402; mouser# 754-RG1005P-49R9-BT5
R31: 10R; r_0402; mouser# 660-RK73H1ERTTP10R0F
R32, R33, R35: 390R; r_0402; mouser# 667-ERJ-2RKF3900X
R57, R58, R59, R60: 75R; r_0402; mouser# 667-ERJ-2RKF75R0X
R65: 1M; r_0402; mouser# 71-CRCW0402-1.0M-E3
T1: H1102; mouser# 673-H1102NL
U7: TS3USB3031; PWQFN-N12; mouser# 595-TS3USB3031RMGR
U8: LAN9514I-JZX; QFN50P900X900X100-65N; mouser# 886-LAN9514I-JZX
X1: 25.000MHz; crystal_smd_5x3.2mm; mouser# 815-ABM3-25-B2-T

Connections:
+1V8: C27.1, C28.1, U8.15 (VDD18CORE), U8.38 (VDD18CORE@1); also elsewhere on the board
+3V3: C30.1, C31.1, C33.1, C36.1, C37.1, C38.1, J4.10, J4.12, L6.1, R18.2, R22.2, R23.2, R35.1, U7.12 (VCC), U8.11 (VBUS_DET), U8.19 (VDD33IO@1), U8.27 (VDD33IO@2), U8.33 (VDD33IO@3), U8.39 (VDD33IO), U8.40 (TEST3), U8.46 (VDD33IO@4); also elsewhere on the board
+5V: C24.1, F2.1, F3.1, L4.1; also elsewhere on the board
/USB & Ethernet/EECLK: U8.23 (EECLK)
/USB & Ethernet/EECS: U8.24 (EECS)
/USB & Ethernet/EEDI: U8.26 (EEDI)
/USB & Ethernet/EEDO: U8.25 (EEDO)
/USB & Ethernet/ORX+: J4.3, T1.11 (RX+)
/USB & Ethernet/ORX-: J4.6, T1.9 (RX-)
/USB & Ethernet/OTX+: J4.1, T1.16 (TX+)
/USB & Ethernet/OTX-: J4.2, T1.14 (TX-)
/USB & Ethernet/PRTCTL4: D2.2 (A), U8.17 (PRTCTL4)
/USB & Ethernet/PRTCTL5: D3.2 (A), U8.18 (PRTCTL5)
/USB & Ethernet/RX+: C50.1, R29.2, T1.6 (RD+), U8.52 (RXP)
/USB & Ethernet/RX-: C49.1, R30.2, T1.8 (RD-), U8.53 (RXN)
/USB & Ethernet/TX+: C47.1, R27.2, T1.1 (TD+), U8.55 (TXP)
/USB & Ethernet/TX-: C46.1, R28.2, T1.3 (TD-), U8.56 (TXN)
/USB & Ethernet/USB_OTG+: J3.3 (USB_DP), R16.1
/USB & Ethernet/USB_OTG-: J3.2 (USB_DN), R15.1
/USB & Ethernet/VDD3V3A: C39.1, C40.1, C41.1, C42.1, C43.1, C44.1, L6.2, R27.1, R28.1, R29.1, R30.1, R31.1, U8.5 (VDD33A), U8.10 (VDD33A@1), U8.49 (VDD33A@2), U8.51 (VDD33A@3), U8.54 (VDD33A@4), U8.57 (VDD33A@5), U8.64 (VDD33A@6)
/USB & Ethernet/VDDUSBPLL: C29.1, L5.1, U8.62 (VDD18USBPLL)
/USB & Ethernet/nFDC_LED: D4.1 (K), U8.20 (NFDX_LED/GPIO0)
/USB & Ethernet/nLNKA_LED: R32.2, U8.21 (NLNKA_LED/GPIO1)
/USB & Ethernet/nRESET: C23.1, R18.1, U8.12 (NRESET)
/USB & Ethernet/nSPD_LED: R33.2, U8.22 (NSPD_LED/GPIO2)
GND: C23.2, C24.2, C25.2, C26.2, C27.2, C28.2, C29.2, C30.2, C31.2, C32.2, C33.2, C34.2, C35.2, C36.2, C37.2, C38.2, C39.2, C40.2, C41.2, C42.2, C43.2, C44.2, C45.2, C46.2, C47.2, C49.2, C50.2, C53.2, J3.5 (GND), P9.4 (GND), P13.4 (GND), R19.2, R20.2, R21.2, R24.2, U7.9 (GND), U8.34 (TEST2), U8.65 (VSS); also elsewhere on the board
HUSB0_D+: U8.2 (USBDP2); also elsewhere on the board
HUSB0_D-: U8.1 (USBDM2); also elsewhere on the board
HUSB1_D+: U8.4 (USBDP3); also elsewhere on the board
HUSB1_D-: U8.3 (USBDM3); also elsewhere on the board
HUSB2_D+: P13.3 (D+), U8.7 (USBDP4)
HUSB2_D-: P13.2 (D-), U8.6 (USBDM4)
HUSB3_D+: P9.3 (D+), U8.9 (USBDP5)
HUSB3_D-: P9.2 (D-), U8.8 (USBDM5)
unnamed: C25.1, D2.1 (K), F2.2, P13.1 (VCC)
unnamed: C26.1, D3.1 (K), F3.2, P9.1 (VCC)
unnamed: C32.1, R65.1, U8.60 (XO), X1.1
unnamed: C34.1, L5.2, U8.48 (VDD18ETHPLL)
unnamed: C35.1, R65.2, U8.61 (XI), X1.2
unnamed: C45.1, R31.2, T1.2 (CT), T1.7 (CT)
unnamed: C53.1, R57.1, R58.1, R59.2, R60.2
unnamed: D4.2 (A), R35.2
unnamed: J3.1 (VBUS), L4.2
unnamed: J4.4, J4.5, R59.1
unnamed: J4.7, J4.8, R60.1
unnamed: J4.9, R33.1
unnamed: J4.11, R32.1
unnamed: R19.1, U7.2 (SEL1)
unnamed: R20.1, U8.63 (USBRBIAS)
unnamed: R21.1, U8.50 (EXRES)
unnamed: R22.1, U8.41 (AUTOMDIX_EN)
unnamed: R23.1, U8.28 (NTRST)
unnamed: R24.1, U8.44 (CLK24_EN)
unnamed: R57.2, T1.15 (CT)
unnamed: R58.2, T1.10 (CT)
USBS_D+: U7.5 (USB2+), U8.59 (USBDP0)
USBS_D-: U7.6 (USB2-), U8.58 (USBDM0)
USB_D+: U7.11 (D+); also elsewhere on the board
USB_D-: U7.10 (D-); also elsewhere on the board
USB_OTGID: J3.4 (USB_ID); also elsewhere on the board
USB_OTG_D+: R16.2, U7.3 (USB1+)
USB_OTG_D-: R15.2, U7.4 (USB1-)
USB_OTG_SELECT: U7.1 (SEL0); also elsewhere on the board

Notes on the sheet:
Ethernet RJ45 & Magnetics
USB OTG
Dual USB A Conn. with Port Control
USB Mux.
USB Hub & Ethernet Controller

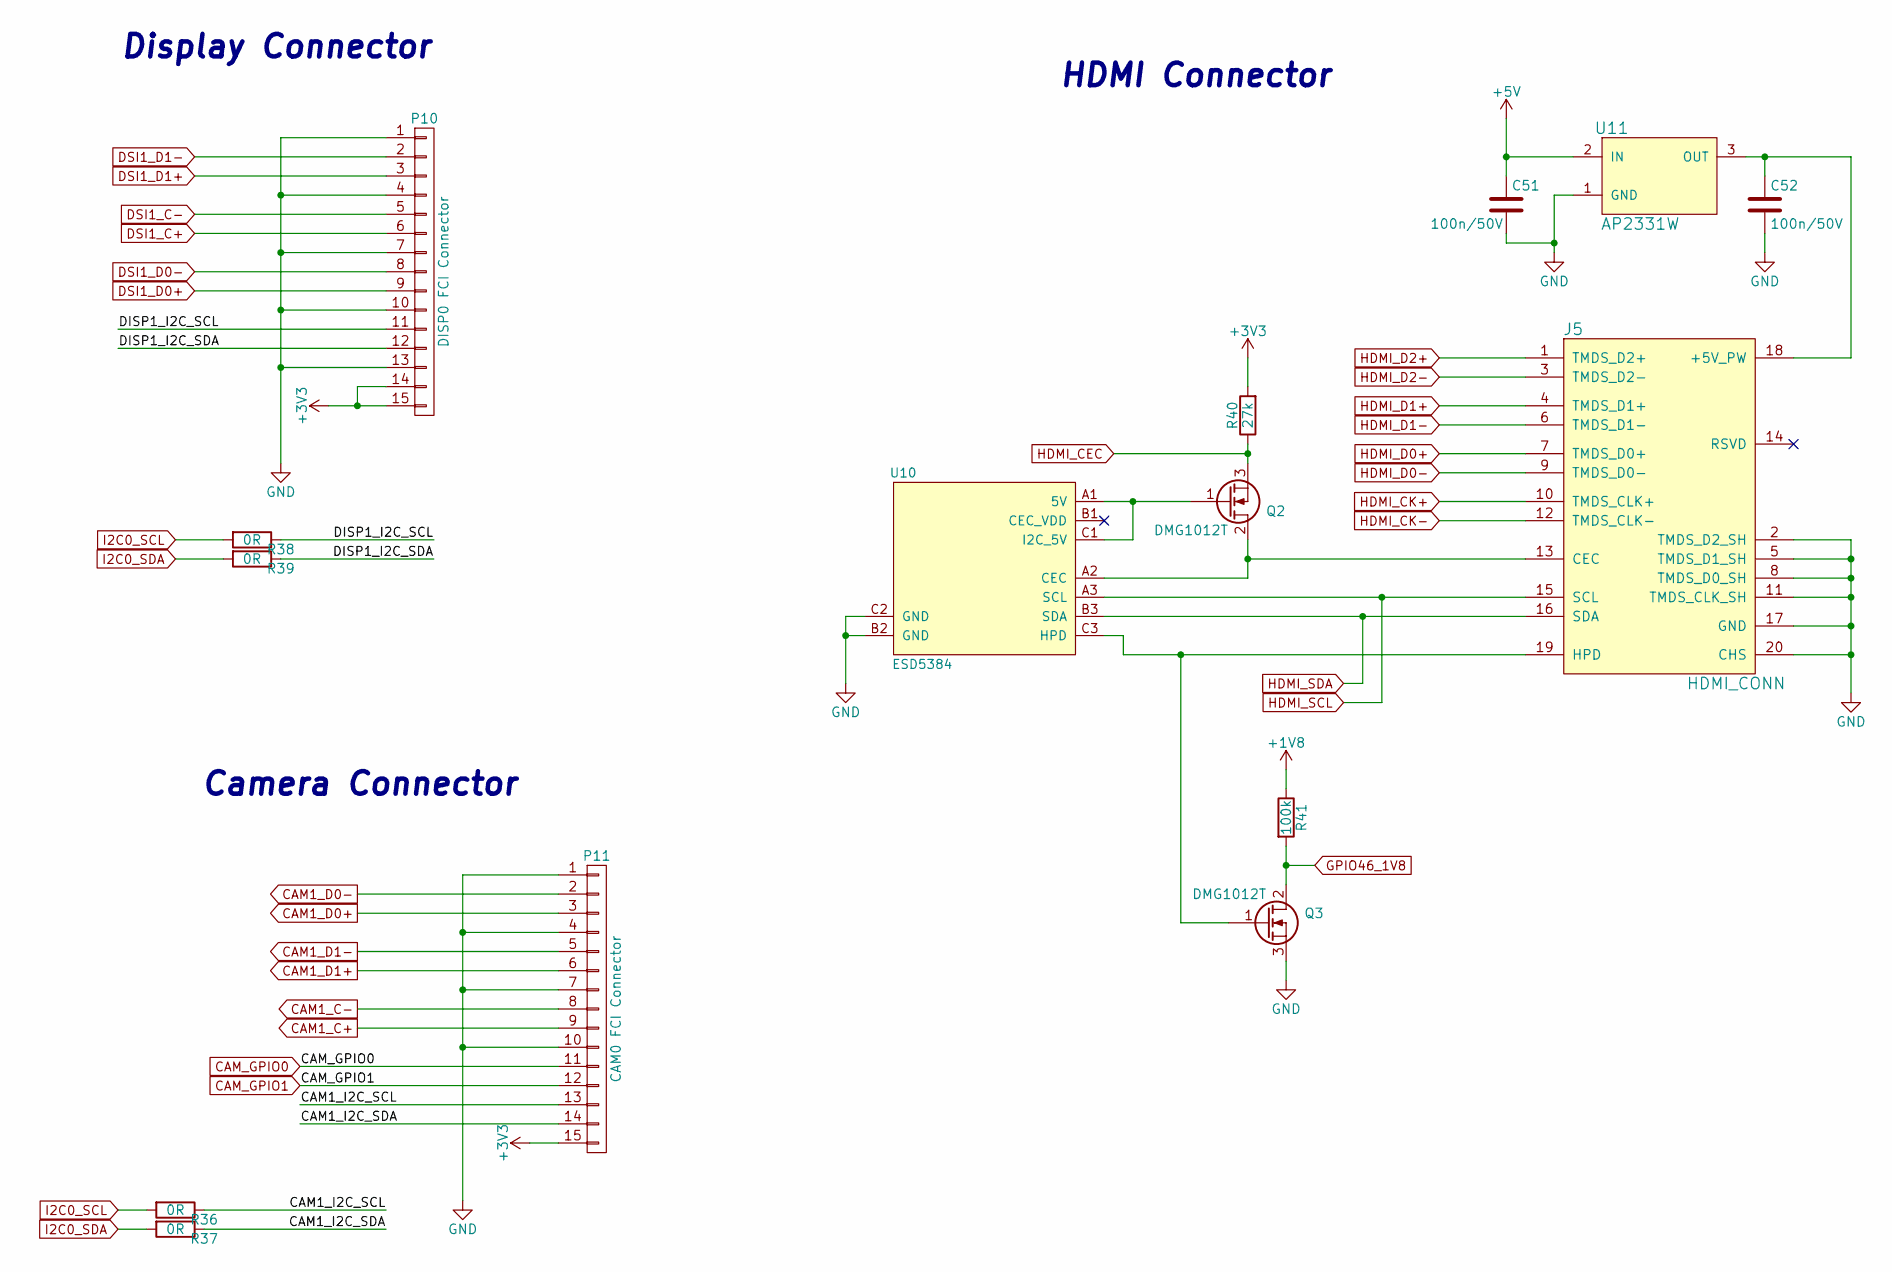
[picture p12: schematic extern_interface.sch, PCIe/104 OneBank Raspberry Pi Compute Module Board]

Parts:
C51, C52: 100n/50V; c_0402; mouser# 81-GRM155R71H104KE4J
J5: HDMI_CONN; 10029449-111RLF; mouser# 649-10029449-111RLF
P10: DISP0 FCI Connector; 1-84952-5; mouser# 571-1-84952-5
P11: CAM0 FCI Connector; 1-84952-5; mouser# 571-1-84952-5
Q2, Q3: DMG1012T; SOT523; mouser# 621-DMG1012T-7
R36, R37, R38, R39: 0R; r_0402; mouser# 71-CRCW0402-0-E3
R40: 27k; r_0402; mouser# 667-ERJ-2GEJ273X
R41: 100k; r_0402; mouser# 667-ERJ-2GEJ104X
U10: ESD5384; WLCSP9; mouser# 863-ESD5384NCTBG
U11: AP2331W; sot23; mouser# 621-AP2331W-7

Connections:
+1V8: R41.1; also elsewhere on the board
+3V3: P10.14, P10.15, P11.15, R40.2; also elsewhere on the board
+5V: C51.1, U11.2 (IN); also elsewhere on the board
/External Interface Components & Connectors/CAM1_I2C_SCL: P11.13, R36.1
/External Interface Components & Connectors/CAM1_I2C_SDA: P11.14, R37.1
/External Interface Components & Connectors/DISP1_I2C_SCL: P10.11, R38.1
/External Interface Components & Connectors/DISP1_I2C_SDA: P10.12, R39.1
CAM1_C+: P11.9; also elsewhere on the board
CAM1_C-: P11.8; also elsewhere on the board
CAM1_D0+: P11.3; also elsewhere on the board
CAM1_D0-: P11.2; also elsewhere on the board
CAM1_D1+: P11.6; also elsewhere on the board
CAM1_D1-: P11.5; also elsewhere on the board
CAM_GPIO0: P11.11; also elsewhere on the board
CAM_GPIO1: P11.12; also elsewhere on the board
DSI1_C+: P10.6; also elsewhere on the board
DSI1_C-: P10.5; also elsewhere on the board
DSI1_D0+: P10.9; also elsewhere on the board
DSI1_D0-: P10.8; also elsewhere on the board
DSI1_D1+: P10.3; also elsewhere on the board
DSI1_D1-: P10.2; also elsewhere on the board
GND: C51.2, C52.2, J5.2 (TMDS_D2_SH), J5.5 (TMDS_D1_SH), J5.8 (TMDS_D0_SH), J5.11 (TMDS_CLK_SH), J5.17 (GND), J5.20 (CHS), P10.1, P10.4, P10.7, P10.10, P10.13, P11.1, P11.4, P11.7, P11.10, Q3.3 (S), U10.B2 (GND), U10.C2 (GND), U11.1 (GND); also elsewhere on the board
GPIO46_1V8: Q3.2 (D), R41.2; also elsewhere on the board
HDMI_CEC: Q2.3 (S), R40.1; also elsewhere on the board
HDMI_CK+: J5.10 (TMDS_CLK+); also elsewhere on the board
HDMI_CK-: J5.12 (TMDS_CLK-); also elsewhere on the board
HDMI_D0+: J5.7 (TMDS_D0+); also elsewhere on the board
HDMI_D0-: J5.9 (TMDS_D0-); also elsewhere on the board
HDMI_D1+: J5.4 (TMDS_D1+); also elsewhere on the board
HDMI_D1-: J5.6 (TMDS_D1-); also elsewhere on the board
HDMI_D2+: J5.1 (TMDS_D2+); also elsewhere on the board
HDMI_D2-: J5.3 (TMDS_D2-); also elsewhere on the board
HDMI_SCL: J5.15 (SCL), U10.A3 (SCL); also elsewhere on the board
HDMI_SDA: J5.16 (SDA), U10.B3 (SDA); also elsewhere on the board
I2C0_SCL: R36.2, R38.2; also elsewhere on the board
I2C0_SDA: R37.2, R39.2; also elsewhere on the board
unnamed: C52.1, J5.18 (+5V_PW), U11.3 (OUT)
unnamed: J5.13 (CEC), Q2.2 (D), U10.A2 (CEC)
unnamed: J5.19 (HPD), Q3.1 (G), U10.C3 (HPD)
unnamed: Q2.1 (G), U10.A1 (5V), U10.C1 (I2C_5V)

Notes on the sheet:
HDMI Connector
Display Connector
Camera Connector
