Roboteurs/Pi-104/hardware/RPi PCIe104 OB Compute Mod.kicad_pcb

## KiCad design hardware/RPi PCIe104 OB Compute Mod.kicad_pcb (continued)

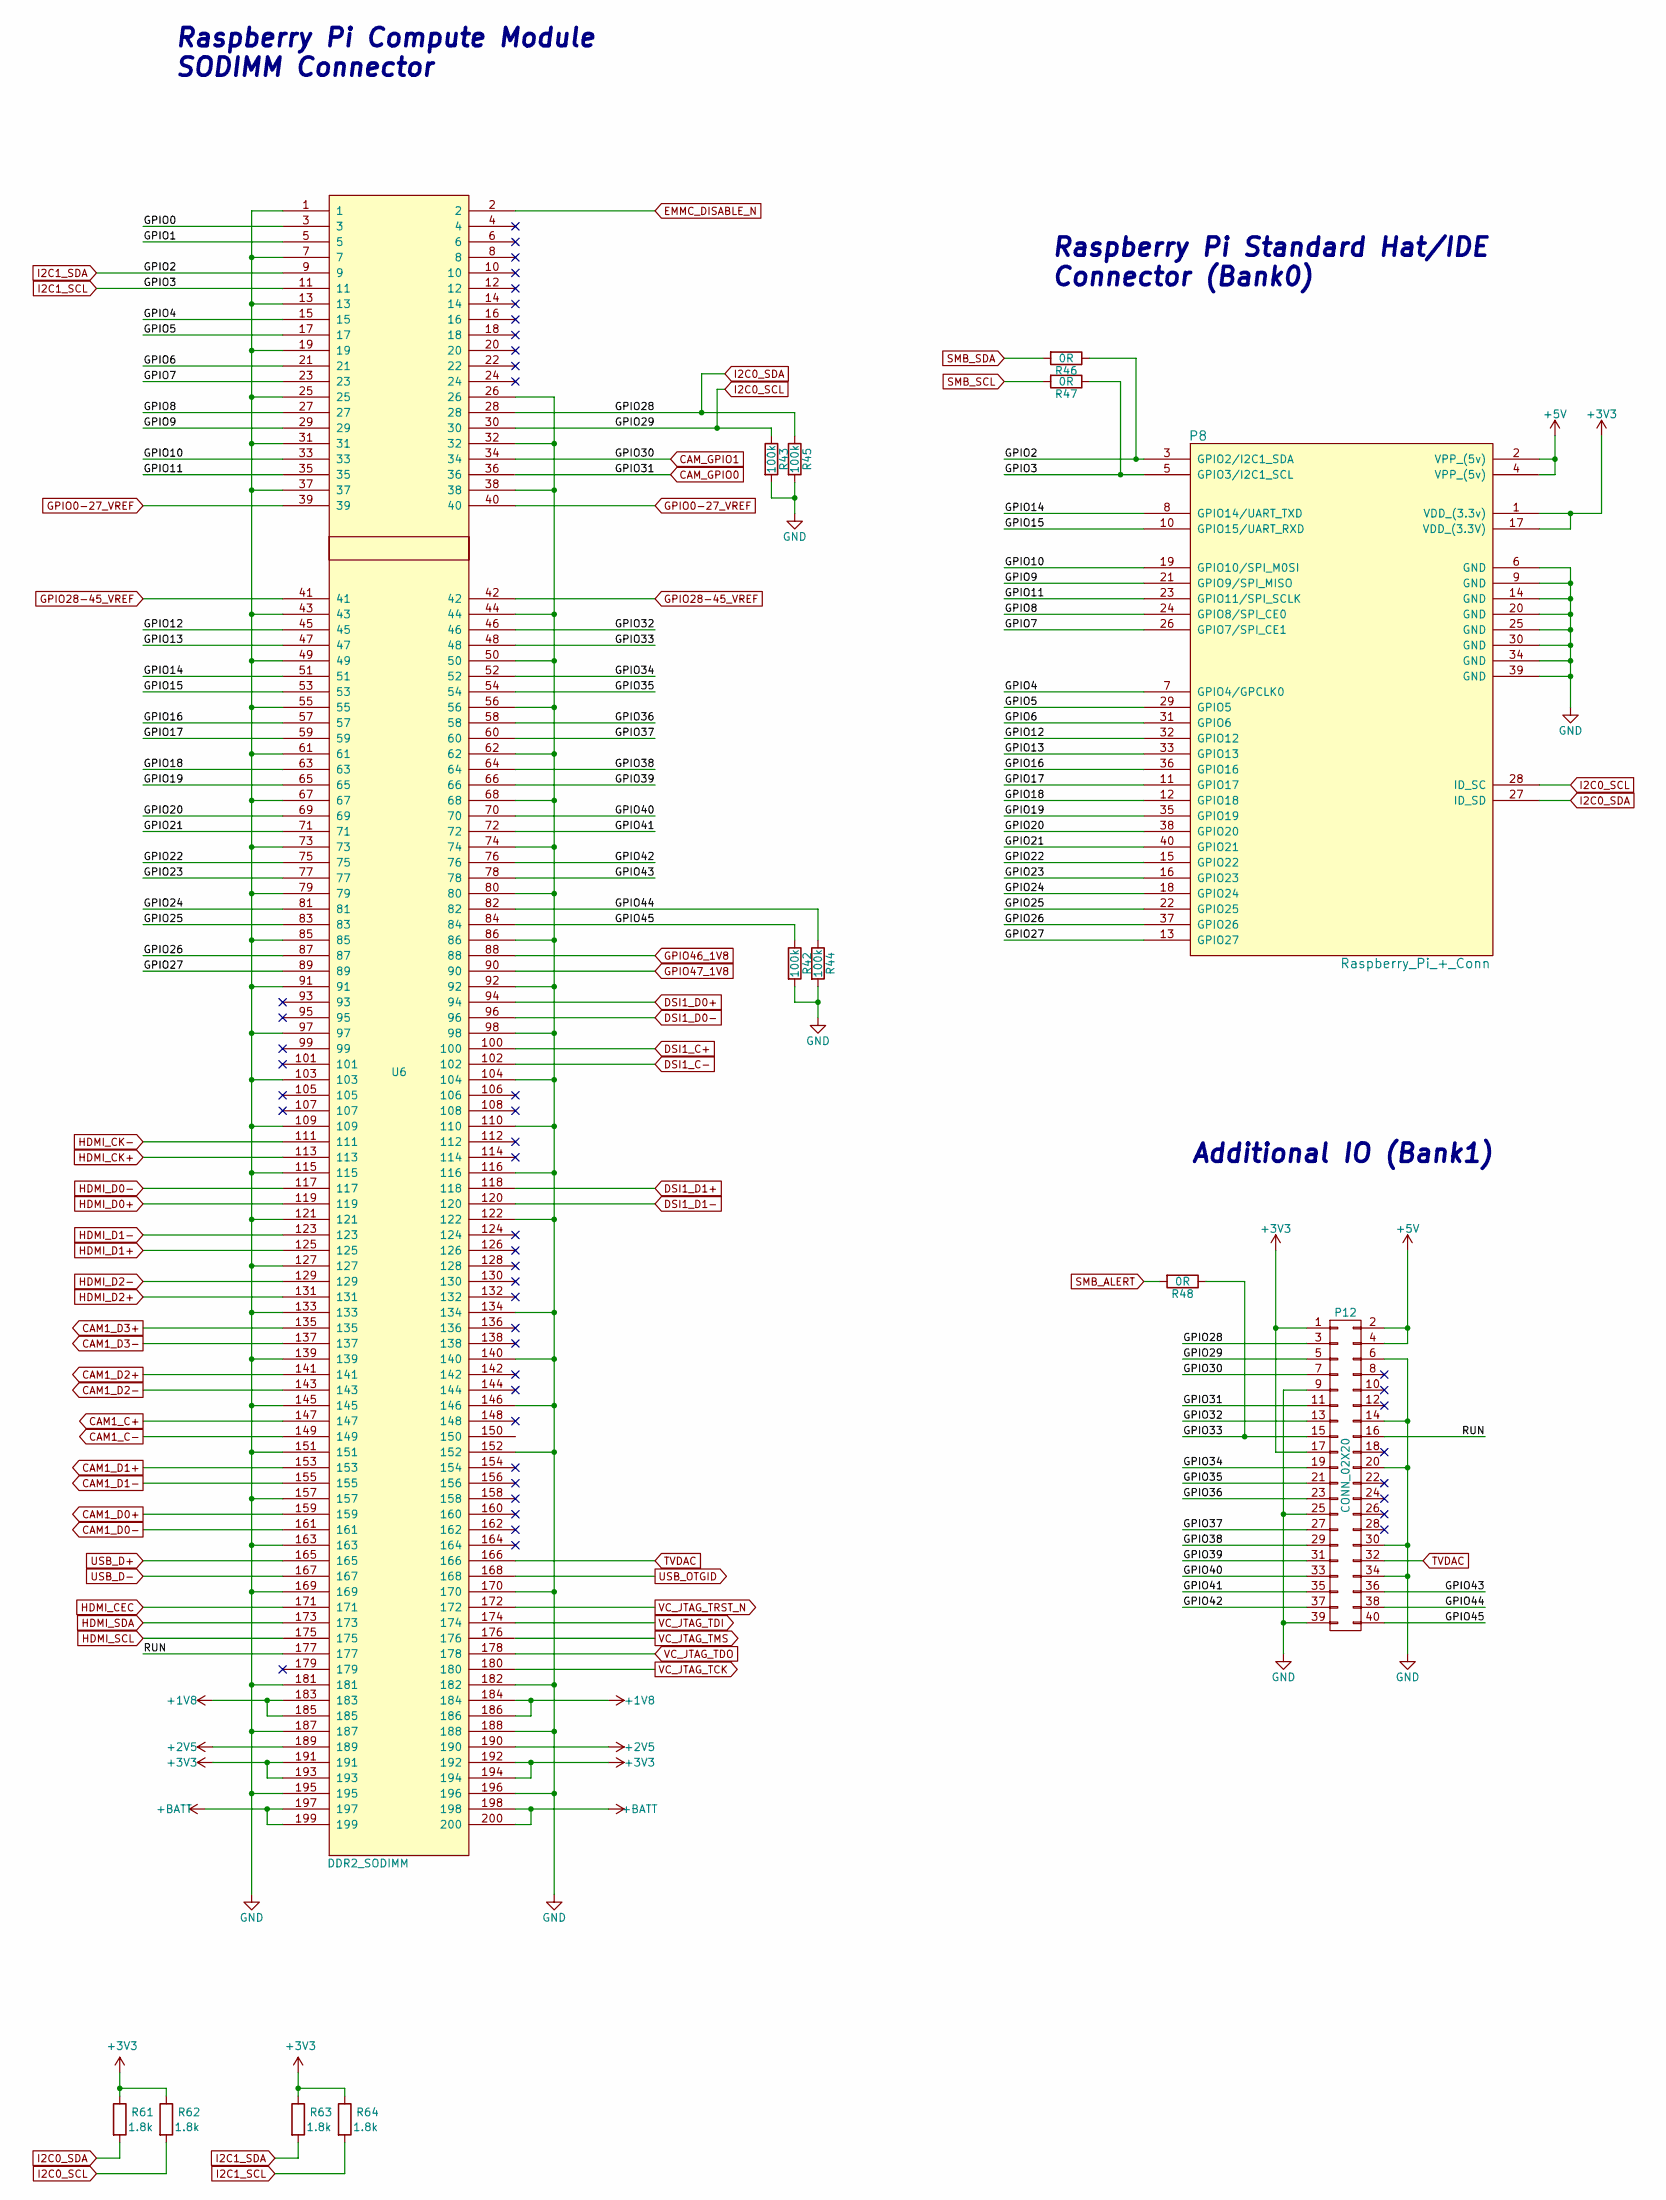
[picture p13: schematic rpi_comm.sch, PCIe/104 OneBank Raspberry Pi Compute Module Board]

Parts:
P8: Raspberry_Pi_+_Conn; vasch_strip_20x2; mouser# 517-N2540-6002RB
P12: CONN_02X20; vasch_strip_20x2; mouser# 517-N2540-6002RB
R42, R43, R44, R45: 100k; r_0402; mouser# 667-ERJ-2GEJ104X
R46, R47, R48: 0R; r_0402; mouser# 71-CRCW0402-0-E3
R61, R62, R63, R64: 1.8k; r_0402; mouser# 667-ERJ-2GEJ182X
U6: DDR2_SODIMM; Socket_SODIMM_DDR1-2_TE_1612618_Debug; mouser# 571-1612618-4

Connections:
+1V8: U6.183, U6.184, U6.185, U6.186; also elsewhere on the board
+2V5: U6.189, U6.190; also elsewhere on the board
+3V3: P8.1 (VDD_(3.3v)), P8.17 (VDD_(3.3V)), P12.1, P12.17, R61.1, R62.1, R63.1, R64.1, U6.191, U6.192, U6.193, U6.194; also elsewhere on the board
+5V: P8.2 (VPP_(5v)), P8.4 (VPP_(5v)), P12.2, P12.4; also elsewhere on the board
+BATT: U6.197, U6.198, U6.199, U6.200; also elsewhere on the board
/Raspberry Pi Mod & I/O/GPIO0: U6.3
/Raspberry Pi Mod & I/O/GPIO1: U6.5
/Raspberry Pi Mod & I/O/GPIO4: P8.7 (GPIO4/GPCLK0), U6.15
/Raspberry Pi Mod & I/O/GPIO5: P8.29 (GPIO5), U6.17
/Raspberry Pi Mod & I/O/GPIO6: P8.31 (GPIO6), U6.21
/Raspberry Pi Mod & I/O/GPIO7: P8.26 (GPIO7/SPI_CE1), U6.23
/Raspberry Pi Mod & I/O/GPIO8: P8.24 (GPIO8/SPI_CE0), U6.27
/Raspberry Pi Mod & I/O/GPIO9: P8.21 (GPIO9/SPI_MISO), U6.29
/Raspberry Pi Mod & I/O/GPIO10: P8.19 (GPIO10/SPI_M0SI), U6.33
/Raspberry Pi Mod & I/O/GPIO11: P8.23 (GPIO11/SPI_SCLK), U6.35
/Raspberry Pi Mod & I/O/GPIO12: P8.32 (GPIO12), U6.45
/Raspberry Pi Mod & I/O/GPIO13: P8.33 (GPIO13), U6.47
/Raspberry Pi Mod & I/O/GPIO14: P8.8 (GPIO14/UART_TXD), U6.51
/Raspberry Pi Mod & I/O/GPIO15: P8.10 (GPIO15/UART_RXD), U6.53
/Raspberry Pi Mod & I/O/GPIO16: P8.36 (GPIO16), U6.57
/Raspberry Pi Mod & I/O/GPIO17: P8.11 (GPIO17), U6.59
/Raspberry Pi Mod & I/O/GPIO18: P8.12 (GPIO18), U6.63
/Raspberry Pi Mod & I/O/GPIO19: P8.35 (GPIO19), U6.65
/Raspberry Pi Mod & I/O/GPIO20: P8.38 (GPIO20), U6.69
/Raspberry Pi Mod & I/O/GPIO21: P8.40 (GPIO21), U6.71
/Raspberry Pi Mod & I/O/GPIO22: P8.15 (GPIO22), U6.75
/Raspberry Pi Mod & I/O/GPIO23: P8.16 (GPIO23), U6.77
/Raspberry Pi Mod & I/O/GPIO24: P8.18 (GPIO24), U6.81
/Raspberry Pi Mod & I/O/GPIO25: P8.22 (GPIO25), U6.83
/Raspberry Pi Mod & I/O/GPIO26: P8.37 (GPIO26), U6.87
/Raspberry Pi Mod & I/O/GPIO27: P8.13 (GPIO27), U6.89
/Raspberry Pi Mod & I/O/GPIO32: P12.13, U6.46
/Raspberry Pi Mod & I/O/GPIO33: P12.15, R48.1, U6.48
/Raspberry Pi Mod & I/O/GPIO34: P12.19, U6.52
/Raspberry Pi Mod & I/O/GPIO35: P12.21, U6.54
/Raspberry Pi Mod & I/O/GPIO36: P12.23, U6.58
/Raspberry Pi Mod & I/O/GPIO37: P12.27, U6.60
/Raspberry Pi Mod & I/O/GPIO38: P12.29, U6.64
/Raspberry Pi Mod & I/O/GPIO39: P12.31, U6.66
/Raspberry Pi Mod & I/O/GPIO40: P12.33, U6.70
/Raspberry Pi Mod & I/O/GPIO41: P12.35, U6.72
/Raspberry Pi Mod & I/O/GPIO42: P12.37, U6.76
/Raspberry Pi Mod & I/O/GPIO43: P12.36, U6.78
/Raspberry Pi Mod & I/O/GPIO44: P12.38, R44.1, U6.82
/Raspberry Pi Mod & I/O/GPIO45: P12.40, R42.1, U6.84
/Raspberry Pi Mod & I/O/RUN: P12.16, U6.177
CAM1_C+: U6.147; also elsewhere on the board
CAM1_C-: U6.149; also elsewhere on the board
CAM1_D0+: U6.159; also elsewhere on the board
CAM1_D0-: U6.161; also elsewhere on the board
CAM1_D1+: U6.153; also elsewhere on the board
CAM1_D1-: U6.155; also elsewhere on the board
CAM1_D2+: U6.141
CAM1_D2-: U6.143
CAM1_D3+: U6.135
CAM1_D3-: U6.137
CAM_GPIO0: P12.11, U6.36; also elsewhere on the board
CAM_GPIO1: P12.7, U6.34; also elsewhere on the board
DSI1_C+: U6.100; also elsewhere on the board
DSI1_C-: U6.102; also elsewhere on the board
DSI1_D0+: U6.94; also elsewhere on the board
DSI1_D0-: U6.96; also elsewhere on the board
DSI1_D1+: U6.118; also elsewhere on the board
DSI1_D1-: U6.120; also elsewhere on the board
EMMC_DISABLE_N: U6.2; also elsewhere on the board
GND: P8.6 (GND), P8.9 (GND), P8.14 (GND), P8.20 (GND), P8.25 (GND), P8.30 (GND), P8.34 (GND), P8.39 (GND), P12.6, P12.9, P12.14, P12.20, P12.25, P12.30, P12.34, P12.39, R42.2, R43.2, R44.2, R45.2, U6.1, U6.7, U6.13, U6.19, U6.25, U6.26, U6.31, U6.32, U6.37, U6.38, U6.43, U6.44, U6.49, U6.50, U6.55, U6.56, U6.61, U6.62, U6.67, U6.68, U6.73, U6.74, U6.79, U6.80, U6.85, U6.86, U6.91, U6.92, U6.97, U6.98, U6.103, U6.104, U6.109, U6.110, U6.115, U6.116, U6.121, U6.122, U6.127, U6.133, U6.134, U6.139, U6.140, U6.145, U6.146, U6.151, U6.152, U6.157, U6.163, U6.169, U6.170, U6.181, U6.182, U6.187, U6.188, U6.195, U6.196; also elsewhere on the board
GPIO0-27_VREF: U6.39, U6.40; also elsewhere on the board
GPIO28-45_VREF: U6.41, U6.42; also elsewhere on the board
GPIO46_1V8: U6.88; also elsewhere on the board
GPIO47_1V8: U6.90; also elsewhere on the board
HDMI_CEC: U6.171; also elsewhere on the board
HDMI_CK+: U6.113; also elsewhere on the board
HDMI_CK-: U6.111; also elsewhere on the board
HDMI_D0+: U6.119; also elsewhere on the board
HDMI_D0-: U6.117; also elsewhere on the board
HDMI_D1+: U6.125; also elsewhere on the board
HDMI_D1-: U6.123; also elsewhere on the board
HDMI_D2+: U6.131; also elsewhere on the board
HDMI_D2-: U6.129; also elsewhere on the board
HDMI_SCL: U6.175; also elsewhere on the board
HDMI_SDA: U6.173; also elsewhere on the board
I2C0_SCL: P8.28 (ID_SC), P12.5, R43.1, R62.2, U6.30; also elsewhere on the board
I2C0_SDA: P8.27 (ID_SD), P12.3, R45.1, R61.2, U6.28; also elsewhere on the board
I2C1_SCL: P8.5 (GPIO3/I2C1_SCL), R47.1, R64.2, U6.11
I2C1_SDA: P8.3 (GPIO2/I2C1_SDA), R46.1, R63.2, U6.9
SMB_ALERT: R48.2; also elsewhere on the board
SMB_SCL: R47.2; also elsewhere on the board
SMB_SDA: R46.2; also elsewhere on the board
TVDAC: P12.32, U6.166
USB_D+: U6.165; also elsewhere on the board
USB_D-: U6.167; also elsewhere on the board
USB_OTGID: U6.168; also elsewhere on the board
VC_JTAG_TCK: U6.180
VC_JTAG_TDI: U6.174
VC_JTAG_TDO: U6.178
VC_JTAG_TMS: U6.176
VC_JTAG_TRST_N: U6.172

Notes on the sheet:
Raspberry Pi Compute Module SODIMM Connector
Raspberry Pi Standard Hat/IDE Connector (Bank0)
Additional IO (Bank1)

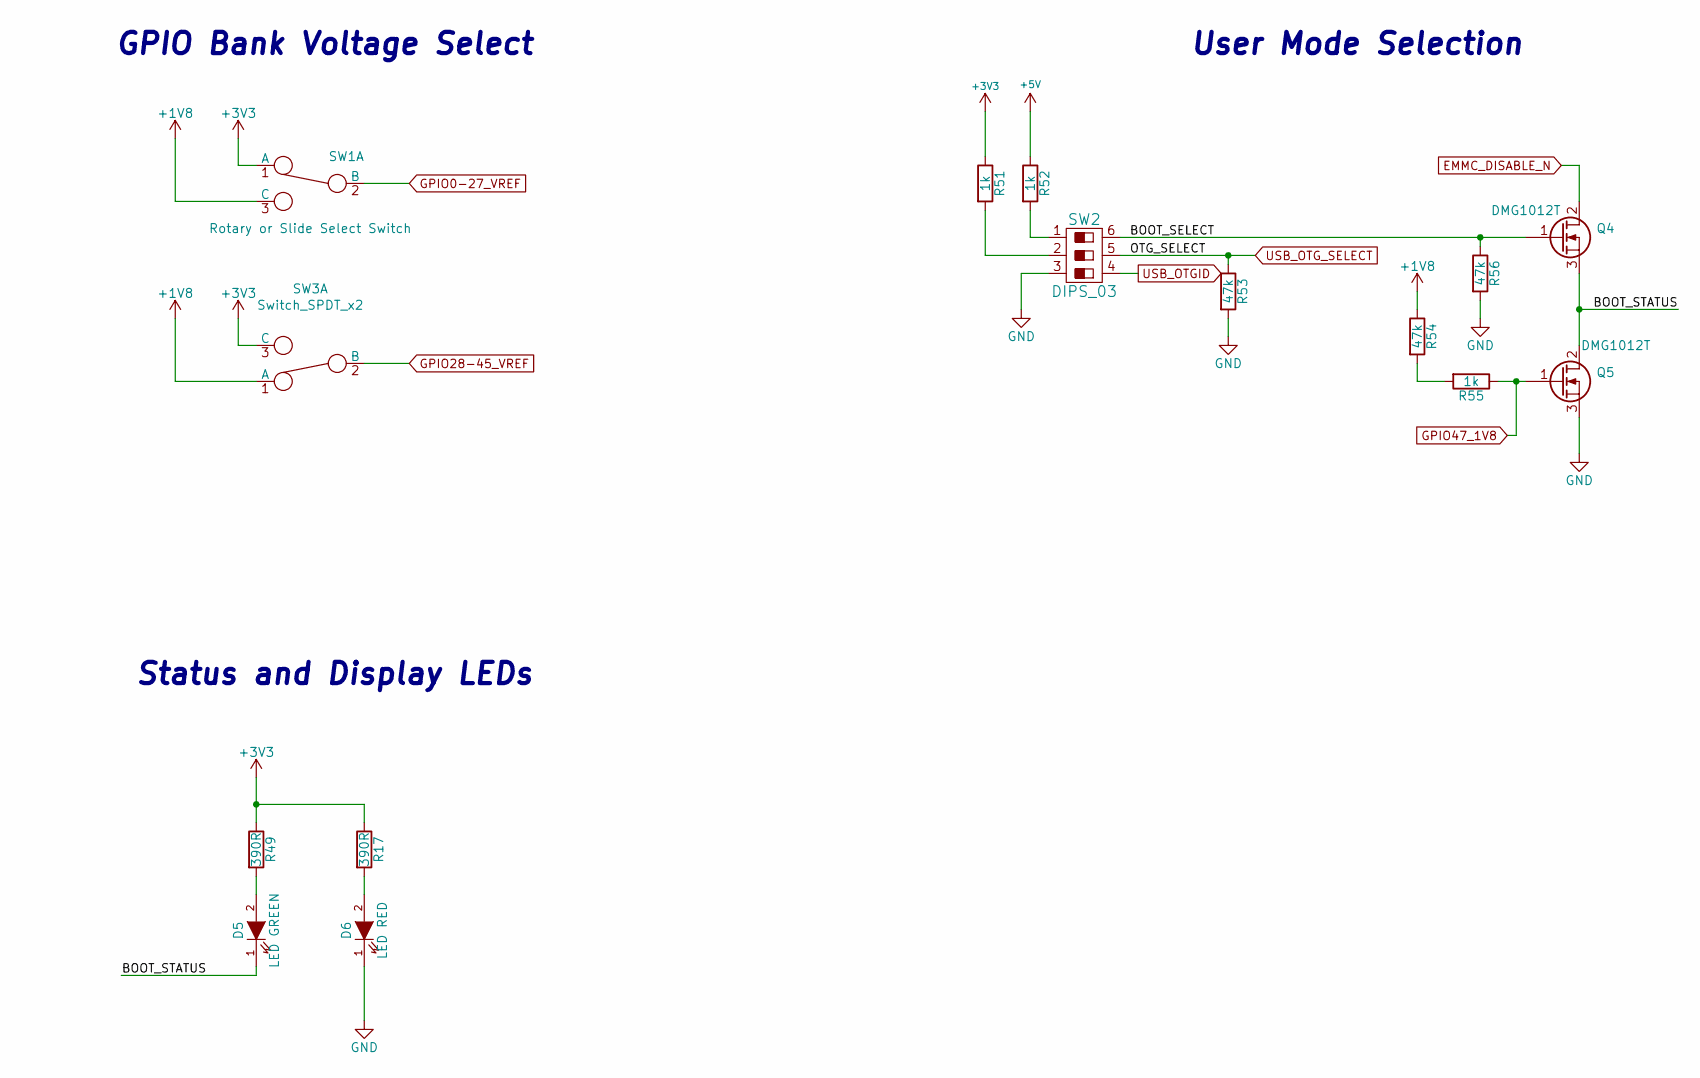
[picture p14: schematic file58442349.sch, PCIe/104 OneBank Raspberry Pi Compute Module Board]

Parts:
D5: LED GREEN; Led_0603; mouser# 743-HT-191YG
D6: LED RED; Led_0603; mouser# 743-HT-191USD
Q4, Q5: DMG1012T; SOT523; mouser# 621-DMG1012T-7
R17, R49: 390R; r_0402; mouser# 667-ERJ-2RKF3900X
R51, R52, R55: 1k; r_0402; mouser# 71-CRCW0402-1.0K-E3
R53, R54, R56: 47k; r_0402; mouser# 71-CRCW0402-47K-E3
SW1: Rotary or Slide Select Switch; SSSS820201; mouser# 688-SSSS820201
SW2: DIPS_03; ADF03S04; mouser# 506-ADF03S04
SW3: Switch_SPDT_x2; SSSS820201; mouser# 688-SSSS820201

Connections:
+1V8: R54.1, SW1.3 (C), SW3.1 (A); also elsewhere on the board
+3V3: R17.1, R49.1, R51.1, SW1.1 (A), SW3.3 (C); also elsewhere on the board
+5V: R52.1; also elsewhere on the board
/User Features & Misc./BOOT_SELECT: Q4.1 (G), R56.1, SW2.6
/User Features & Misc./BOOT_STATUS: D5.1 (K), Q4.3 (S), Q5.2 (D)
EMMC_DISABLE_N: Q4.2 (D); also elsewhere on the board
GND: D6.1 (K), Q5.3 (S), R53.2, R56.2, SW2.3; also elsewhere on the board
GPIO0-27_VREF: SW1.2 (B); also elsewhere on the board
GPIO28-45_VREF: SW3.2 (B); also elsewhere on the board
GPIO47_1V8: Q5.1 (G), R55.1; also elsewhere on the board
unnamed: D5.2 (A), R49.2
unnamed: D6.2 (A), R17.2
unnamed: R51.2, SW2.2
unnamed: R52.2, SW2.1
unnamed: R54.2, R55.2
USB_OTGID: SW2.4; also elsewhere on the board
USB_OTG_SELECT: R53.1, SW2.5; also elsewhere on the board

Notes on the sheet:
GPIO Bank Voltage Select
User Mode Selection
Status and Display LEDs

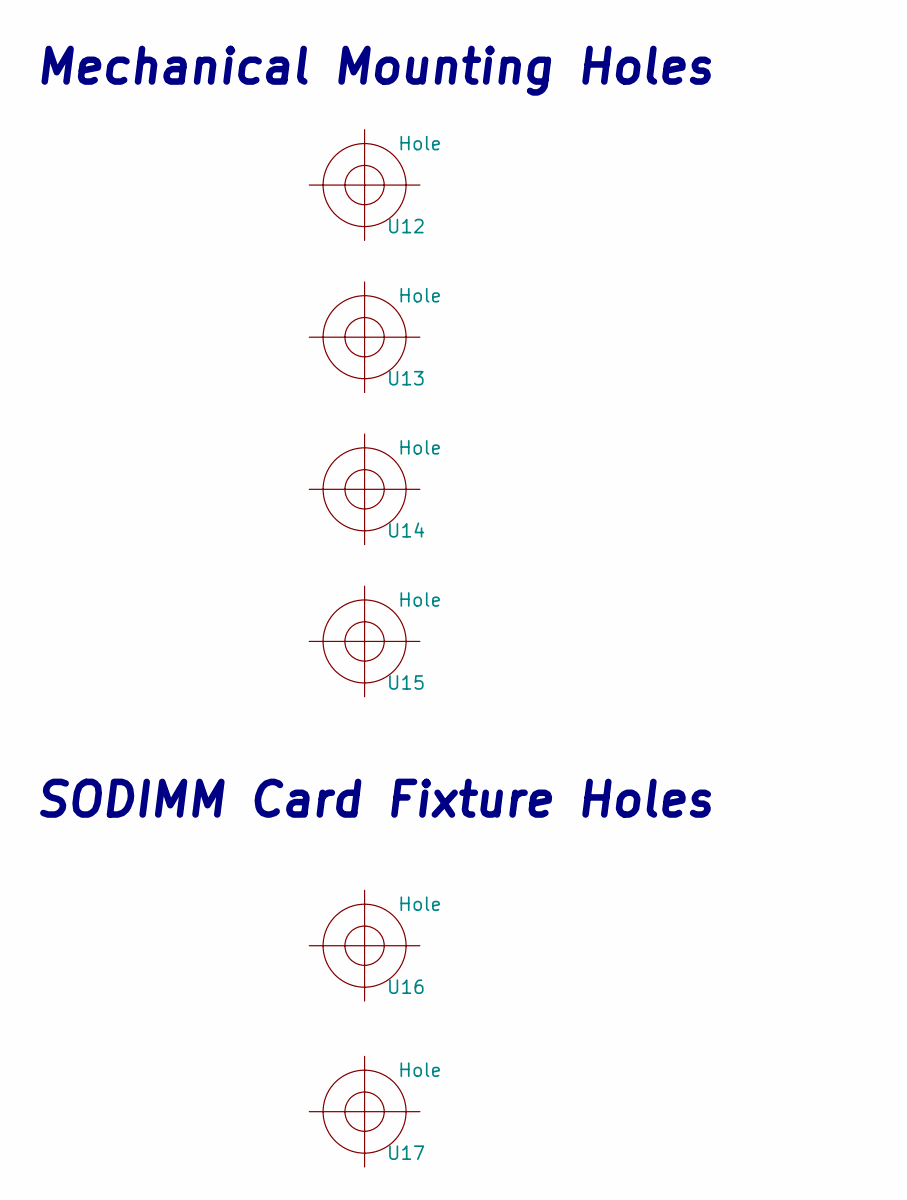
[picture p15: schematic mech.sch, PCIe/104 OneBank Raspberry Pi Compute Module Board]

Parts:
U12, U13, U14, U15, U16, U17: Hole

Notes on the sheet:
Mechanical Mounting Holes
SODIMM Card Fixture Holes

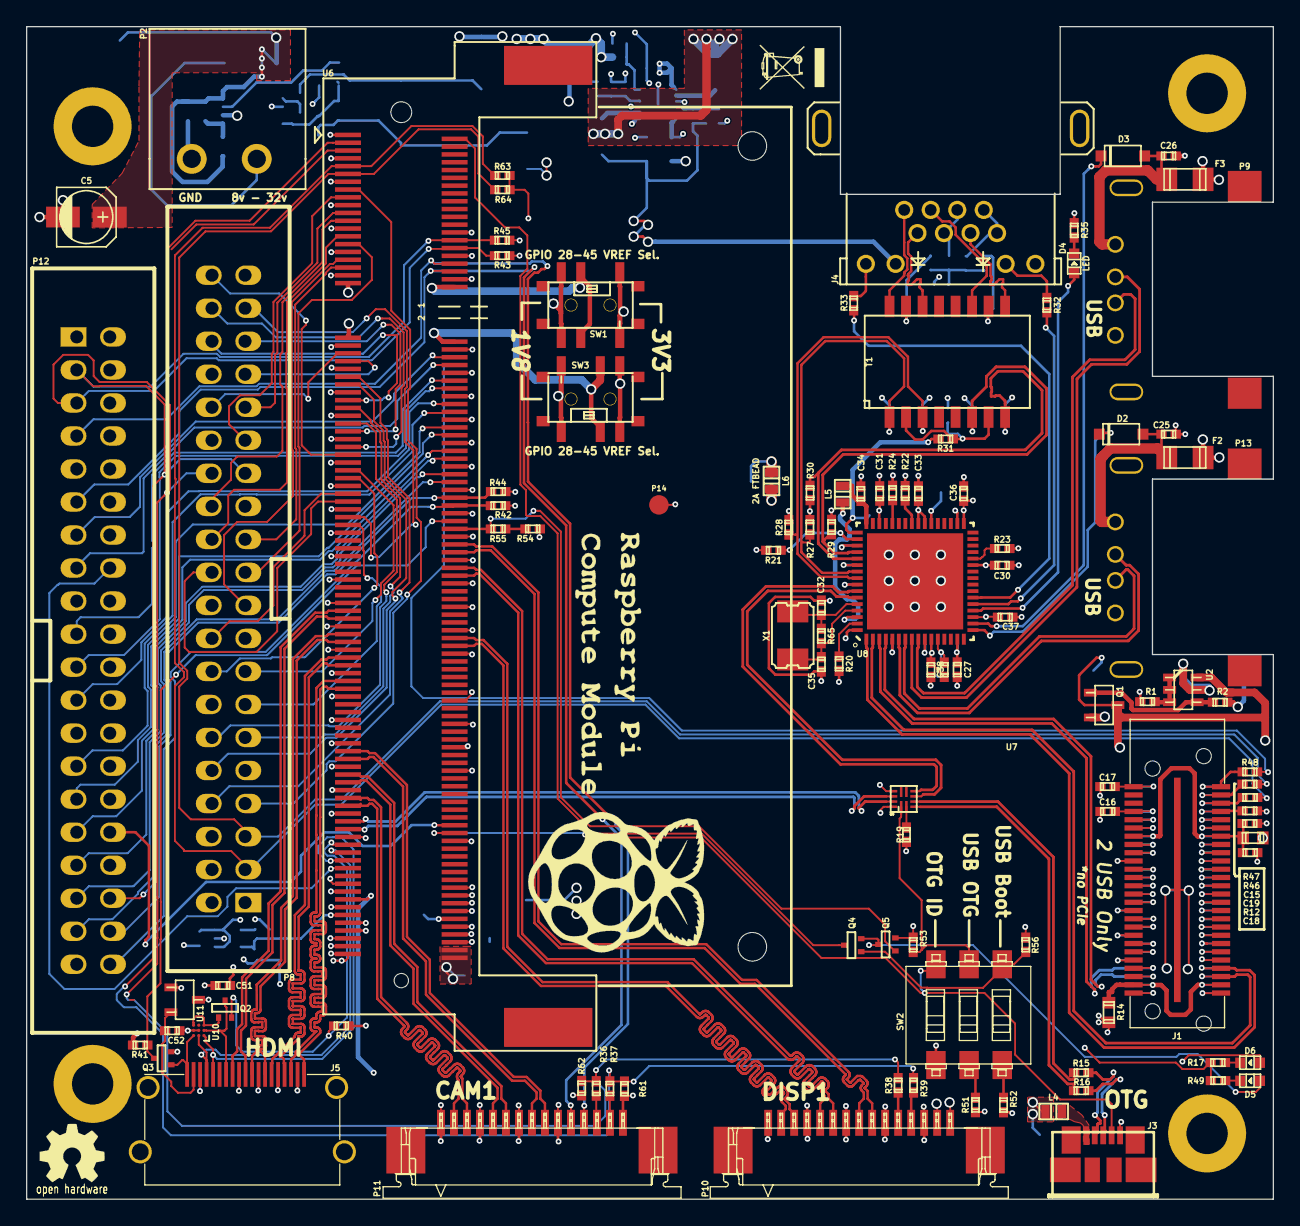
[picture p16: board RPi PCIe104 OB Compute Mod.kicad_pcb from above]

Board: 4 copper layers, 95.9 x 90.2 mm, 173 parts (0 on the bottom side), 201 nets.

Other parts of the board:
H1, H2, H3, H4: PCB_HOLE; PCIE104_HOLE
