Roboteurs/Pi-104/(commit log)

2016-12-19 Initial hardware commit
    [RPi PCIe104 OB Compute Mod.kicad_pcb, RPi PCIe104 OB Compute Mod.sch, RPi PCIe104 OB Compute Mod_conflict-20161215-174237.sch, bom.csv, bom.xlsx, extern_interface.sch, extern_interface_conflict-20161215-174237.sch, file58442349.sch]
2016-12-19 removed all conflict files
    [RPi PCIe104 OB Compute Mod_conflict-20161215-174237.sch, extern_interface_conflict-20161215-174237.sch, file58442349_conflict-20161215-174238.sch, mech_conflict-20161215-174238.sch, onebank_conflict-20161215-174237.sch, power_conflict-20161215-174237.sch, rpi_comm_conflict-20161215-174238.sch, usb_eth_conflict-20161215-174237.sch]
