Roboteurs/Pi-104/(notices)

Notices in the files:
hardware/RPi PCIe104 OB Compute Mod.kicad_pcb:
Authors: See 'doc/CHANGES.txt' file. License: See 'doc/LICENCIA_CIAA_ACC.txt' file.
